EntropicEngineering/amm_connector/renders/connector_assembly.png

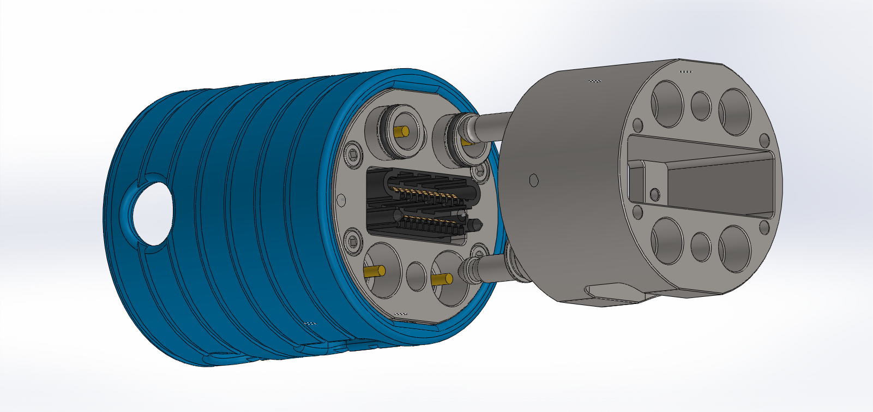
renders/connector_assembly.png
