EntropicEngineering/amm_connector/renders/schrader_test_block.png

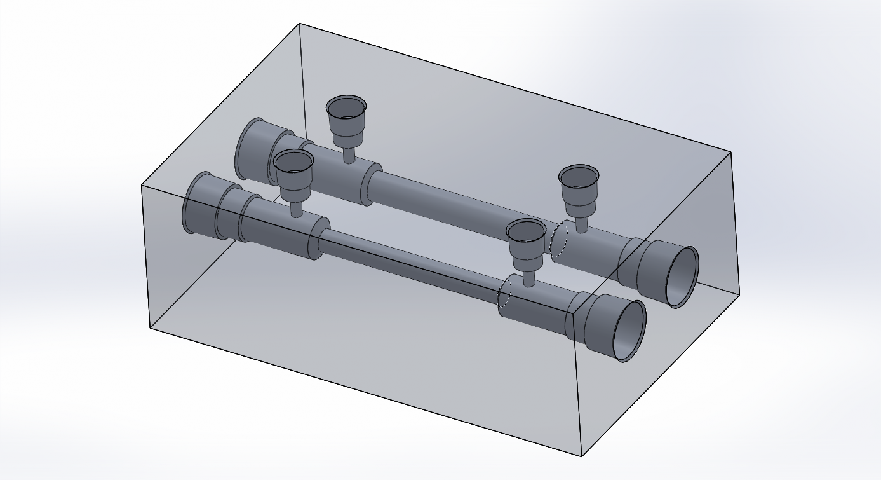
renders/schrader_test_block.png
