EntropicEngineering/amm_connector/README.md

This is a design of a standardized connector the the Advanced Modular Mankin (AMM) Project.
