EntropicEngineering/amm_connector/electrical_pinout.ods

Advanced Modular Manikin Connector Electrical Pinout
Connector Pin | Function | RJ-45 Ethernet Pin | Connector Pin | Function | RJ-45 Ethernet Pin | Mates
1 | +50V |  | 12 | +50V |  | Pin 1 mates with 12
2 | +50V |  | 13 | +50V |  | Pin 2 mates with 13
3 | +50V |  | 14 | +50V |  | Pin 3 mates with 14
4 | N/C |  | 15 | N/C |  | Pin 4 mates with 15
5 | GND |  | 16 | GND |  | Pin 5 mates with 16
6 | GND |  | 17 | GND |  | Pin 6 mates with 17
7 | GND |  | 18 | GND |  | Pin 7 mates with 18
8 | BI_DA+ | 1 | 19 | BI_DA- | 2 | Pin 8 mates with 19
9 | BI_DB+ | 3 | 20 | BI_DB- | 6 | Pin 9 mates with 20
10 | BI_DC+ | 4 | 21 | BI_DC- | 5 | Pin 10 mates with 21
11 | BI_DD+ | 7 | 22 | BI_DD- | 8 | Pin 11 mates with 22
Note
This electrical connector is designed to be fully non-gendered. The polarity of ethernet twisted pairs can be reversed during normal operation; the ethernet controller compensates for this.
