EntropicEngineering/amm_connector/body_model/skin_f_color.png

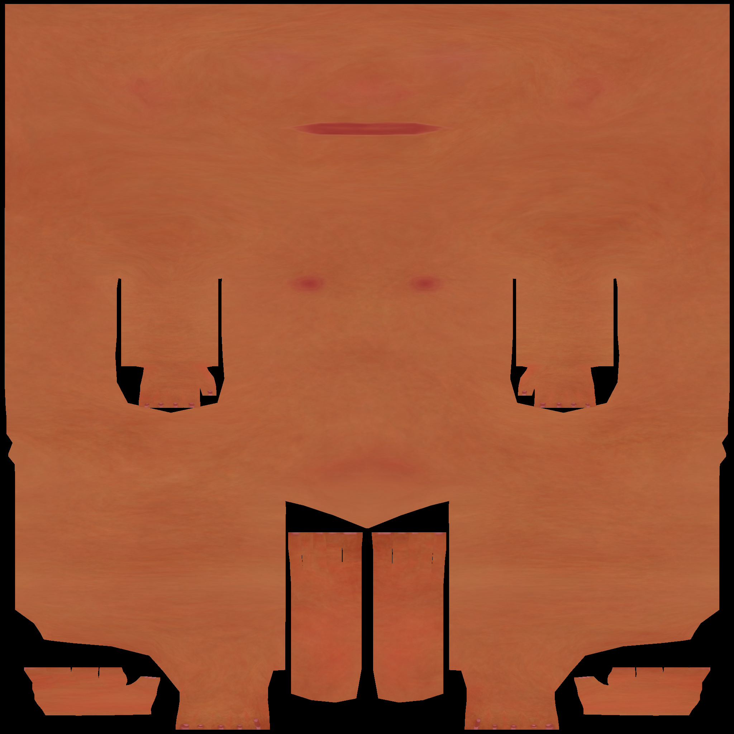
body_model/skin_f_color.png
