EntropicEngineering/amm_connector/body_model/skin_f_norm.png

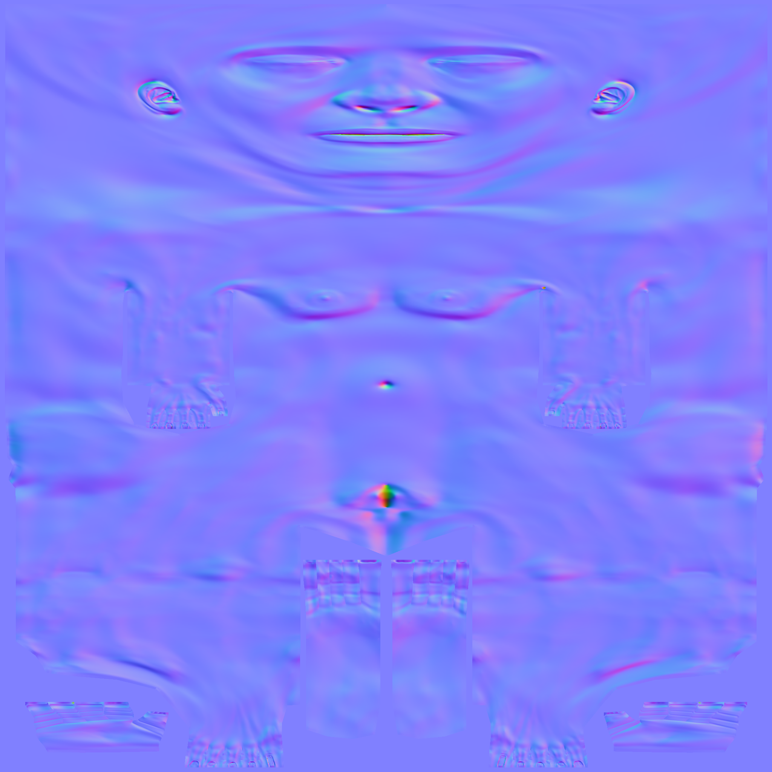
body_model/skin_f_norm.png
