EntropicEngineering/amm_connector/electrical_pinout.png

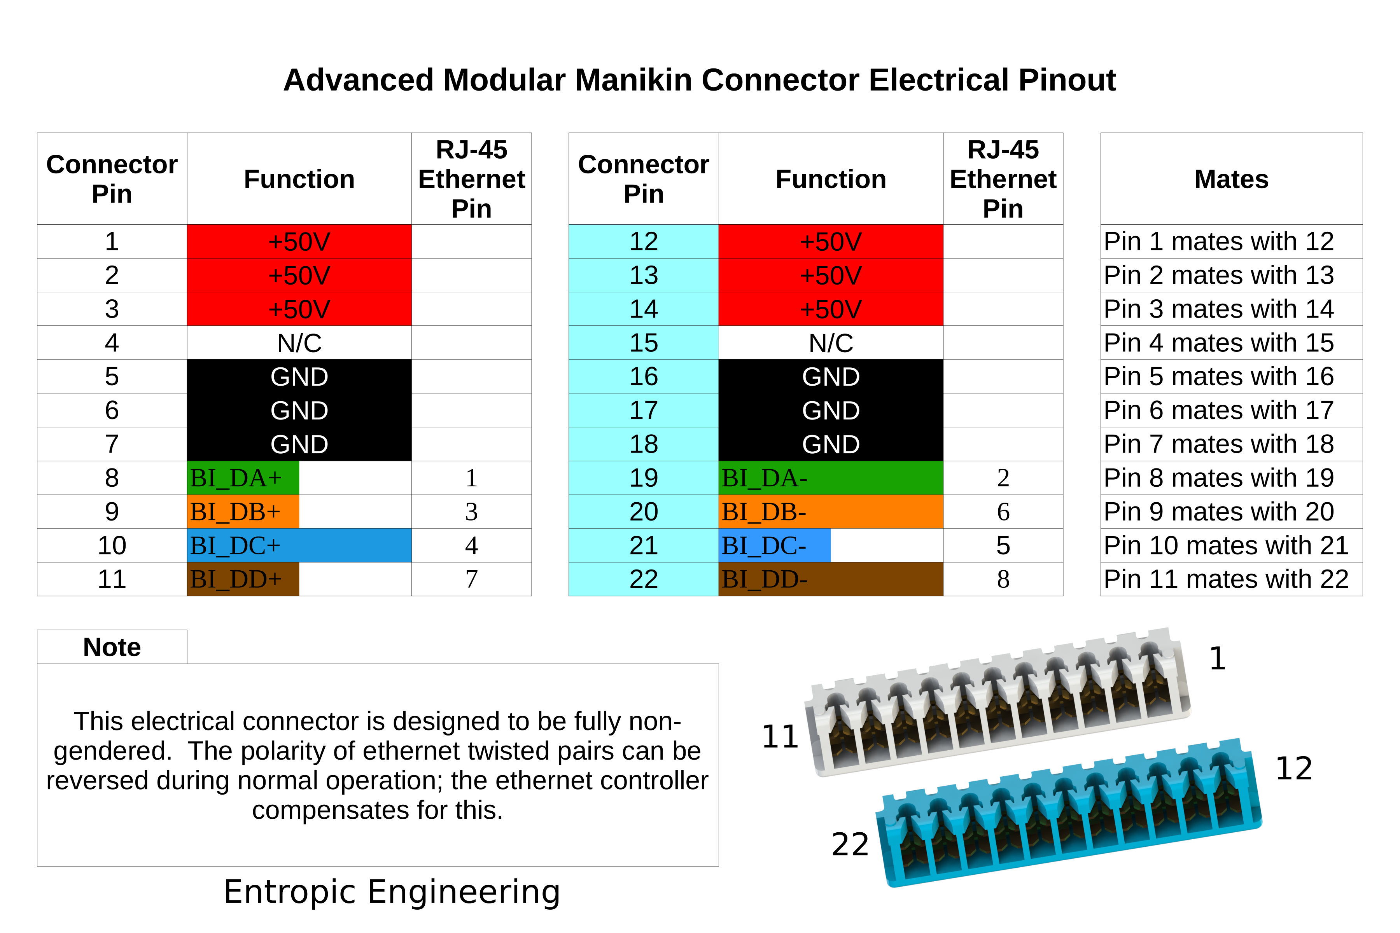
electrical_pinout.png
