EntropicEngineering/amm_connector/renders/connector2.png

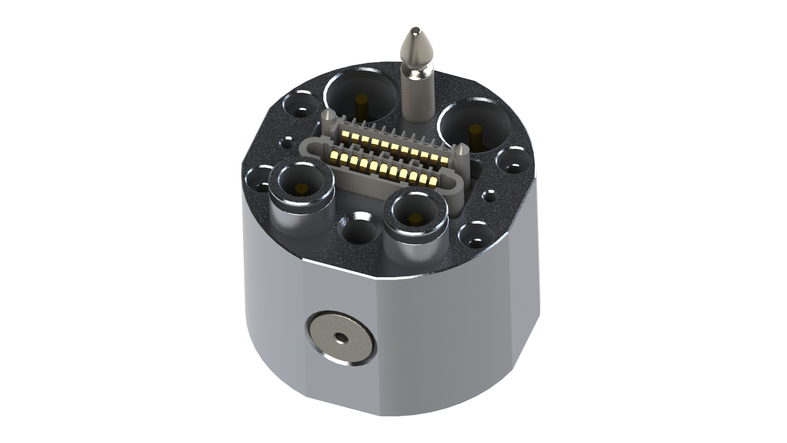
renders/connector2.png
