EntropicEngineering/amm_connector/renders/connector_draft.png

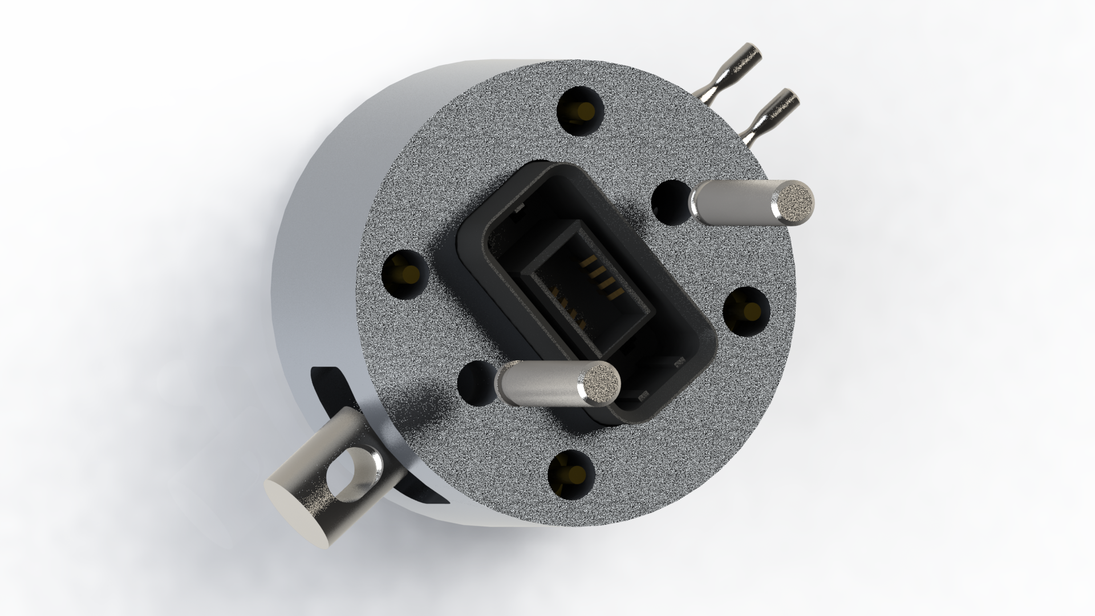
renders/connector_draft.png
