EntropicEngineering/amm_connector/renders/connector_draft_2.png

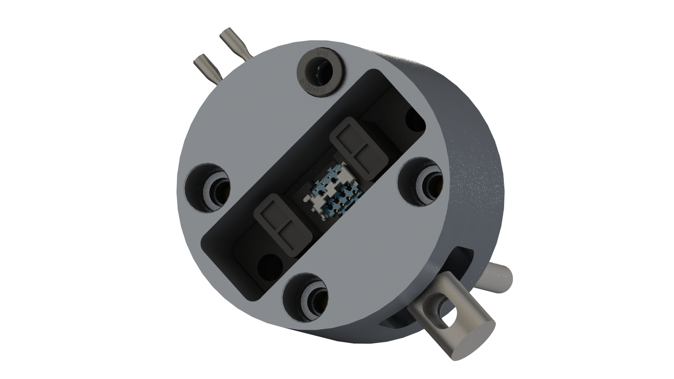
renders/connector_draft_2.png
