EntropicEngineering/amm_connector/renders/connector_draft_3.png

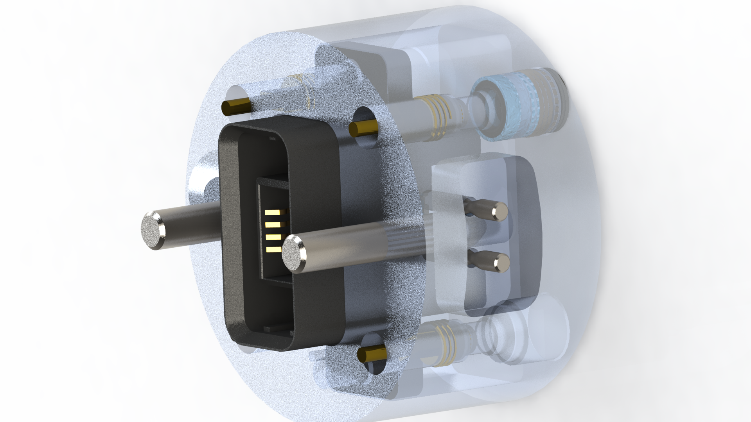
renders/connector_draft_3.png
