EntropicEngineering/amm_connector/renders/connector_draft_4.png

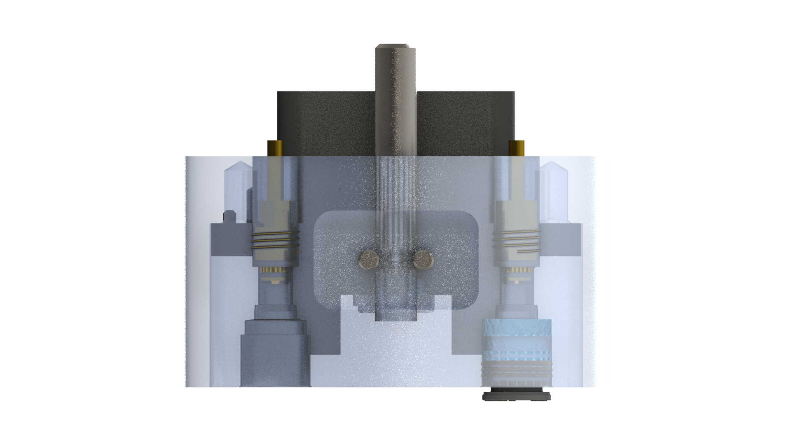
renders/connector_draft_4.png
