EntropicEngineering/amm_connector/renders/connector_draft_5.png

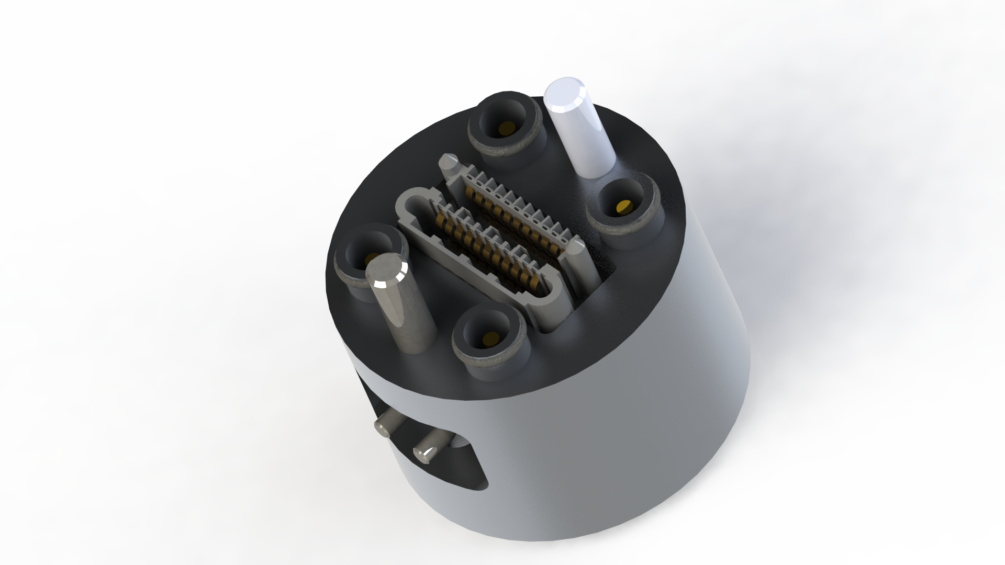
renders/connector_draft_5.png
