EntropicEngineering/amm_connector/renders/connector_draft_6.png

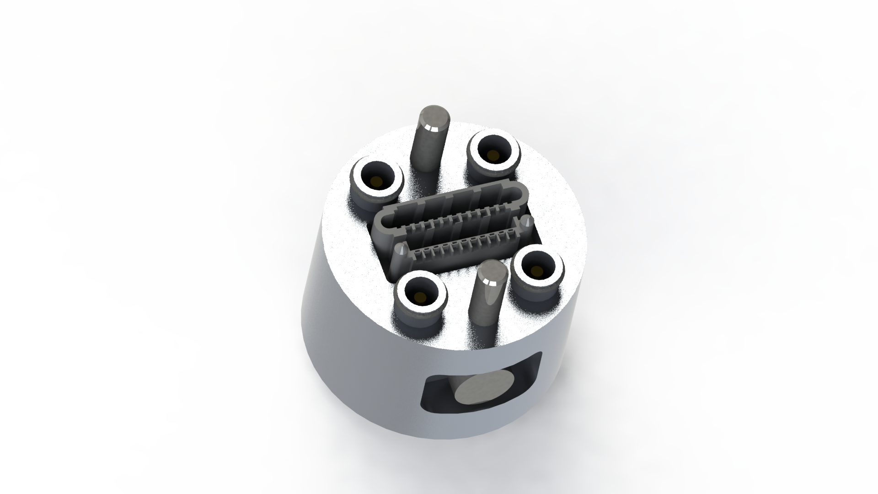
renders/connector_draft_6.png
