EntropicEngineering/amm_connector/renders/connector_draft_7.png

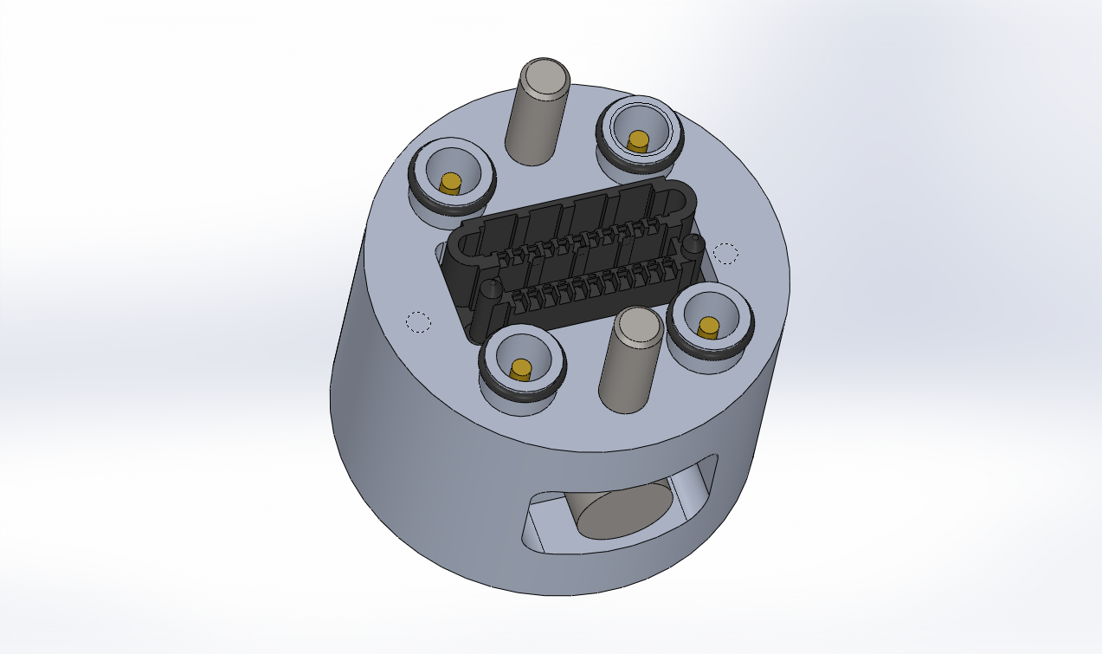
renders/connector_draft_7.png
