EntropicEngineering/amm_connector/renders/connector_draft_8.png

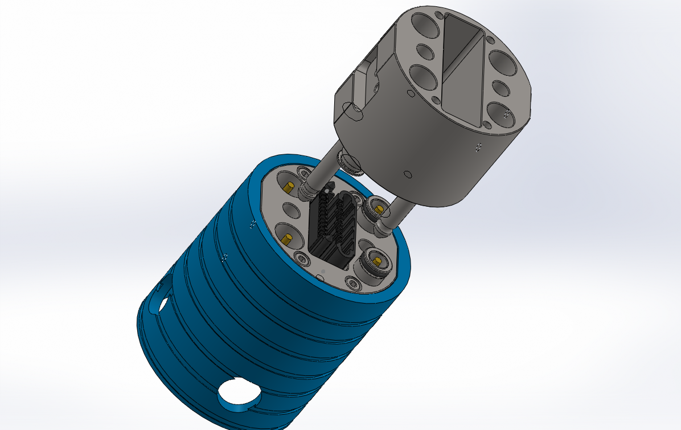
renders/connector_draft_8.png
