EntropicEngineering/amm_connector/renders/connector_draft_9.png

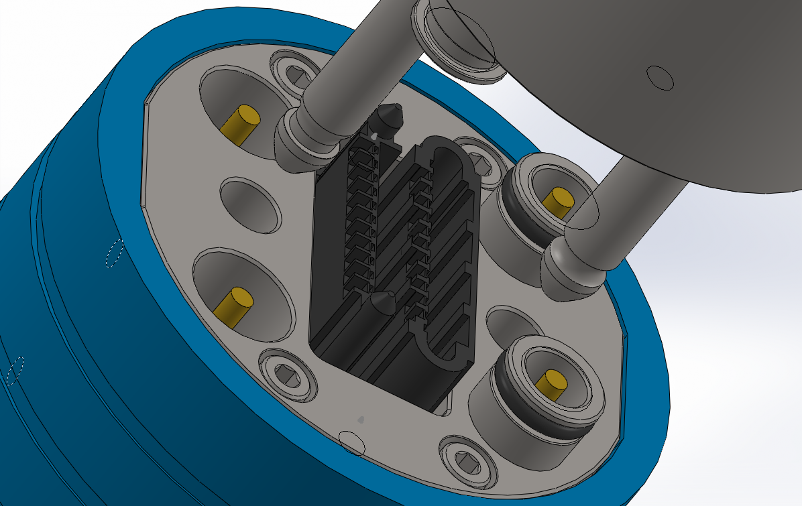
renders/connector_draft_9.png
