EntropicEngineering/amm_connector/renders/electrical_insert_blue.png

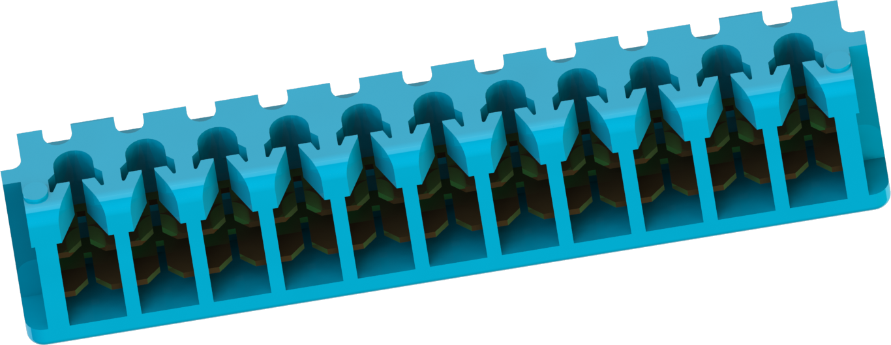
renders/electrical_insert_blue.png
