EntropicEngineering/amm_connector/fluid/hose_connector_subassembly.sldasm

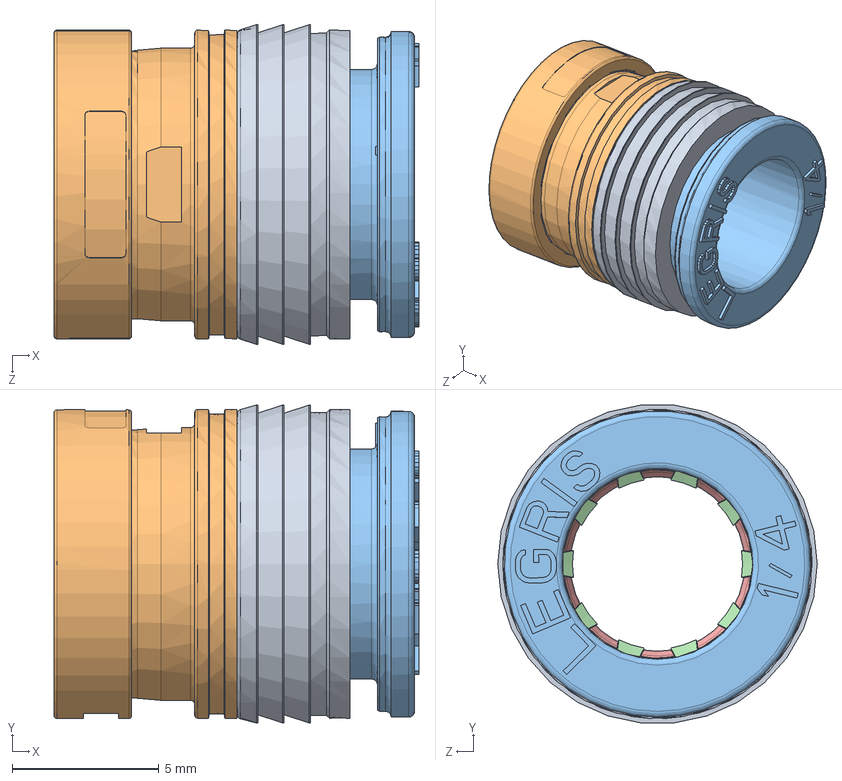
[picture p18: CAD file, 2018-06-09]
fluid/hose_connector_subassembly.sldasm
12.4 x 10.8 x 10.9 mm
