EntropicEngineering/amm_connector/electrical/electrical_subassembly.sldasm

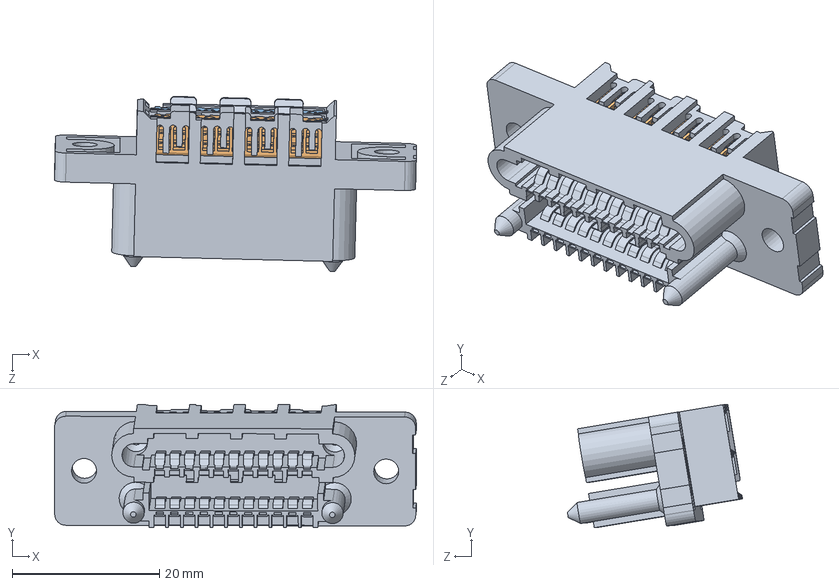
[picture p19: CAD file, 2018-11-02]
electrical/electrical_subassembly.sldasm
49.1 x 16.7 x 23.8 mm
