EntropicEngineering/amm_connector/electrical/electrical_assembly_a.sldasm

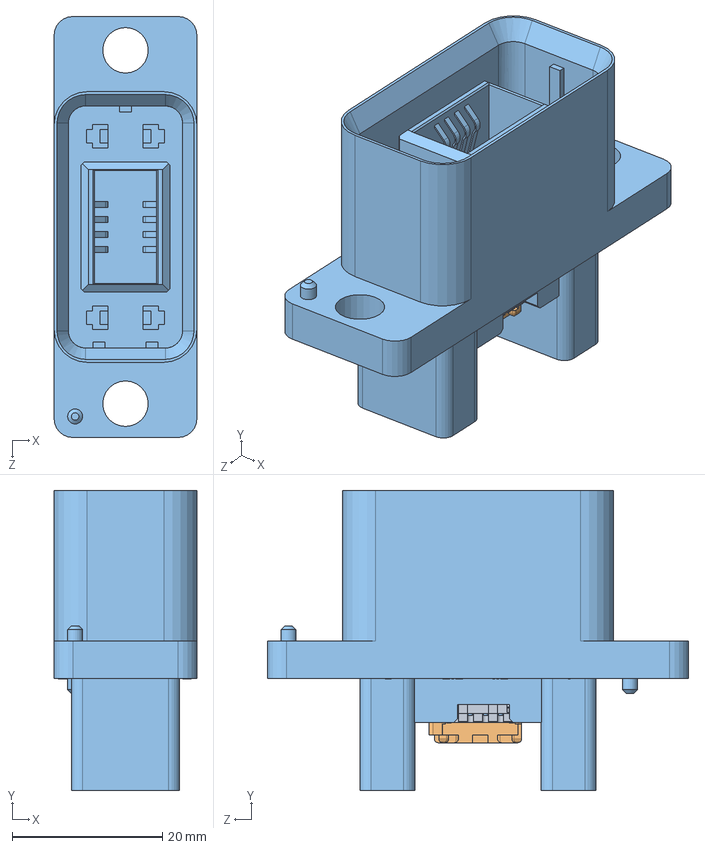
[picture p20: CAD file, 2018-06-05]
electrical/electrical_assembly_a.sldasm
19.0 x 39.9 x 56.0 mm
electrical_connector_a
idc_retainer
idc_insert x 2
