EntropicEngineering/amm_connector/jigs/release_button_jig.sldasm

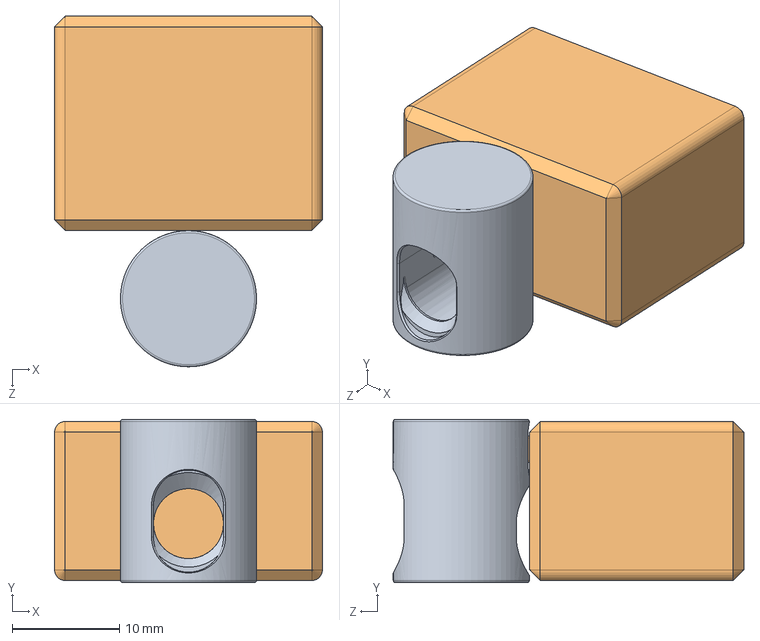
[picture p21: CAD file, 2018-08-15]
jigs/release_button_jig.sldasm
25.0 x 15.2 x 32.7 mm
