EntropicEngineering/amm_connector/body_model/skin_f_3.obj

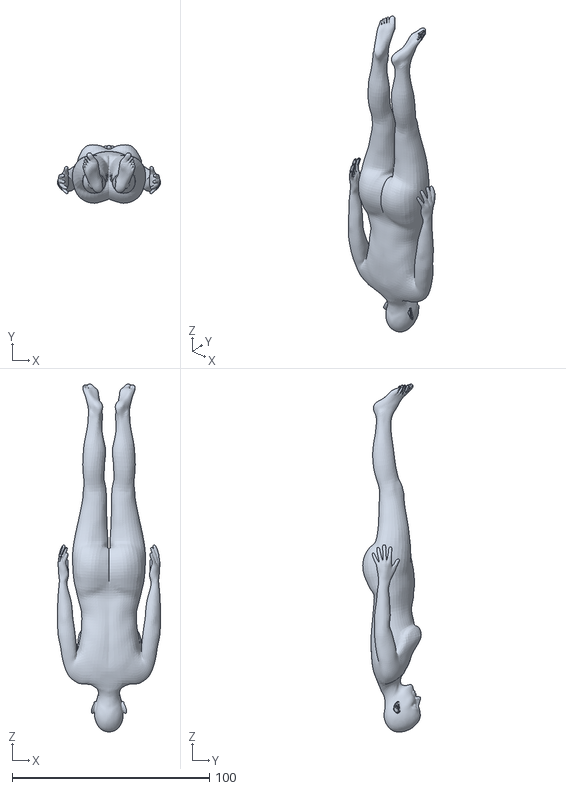
[picture p22: CAD file, 2022-07-11]
body_model/skin_f_3.obj
52.3 x 29.7 x 176.6
