EntropicEngineering/amm_connector/connector_interface_draft/connector_interface.stl

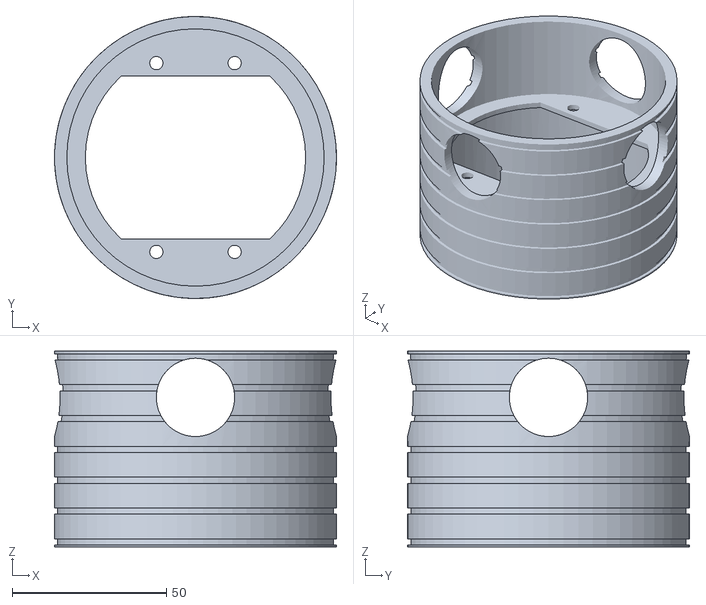
[picture p23: CAD file, 2018-05-30]
connector_interface_draft/connector_interface.stl
91.5 x 91.5 x 63.5
