EntropicEngineering/amm_connector/electrical/3-173977-1.stp

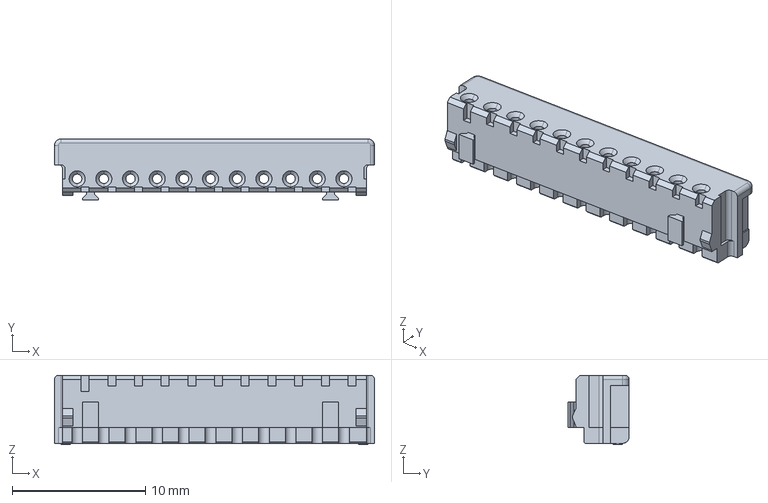
[picture p24: CAD file, 2022-07-11]
electrical/3-173977-1.stp
24.0 x 4.60 x 5.20 mm
