EntropicEngineering/amm_connector/fluid/m8_schrader_valve.sldprt

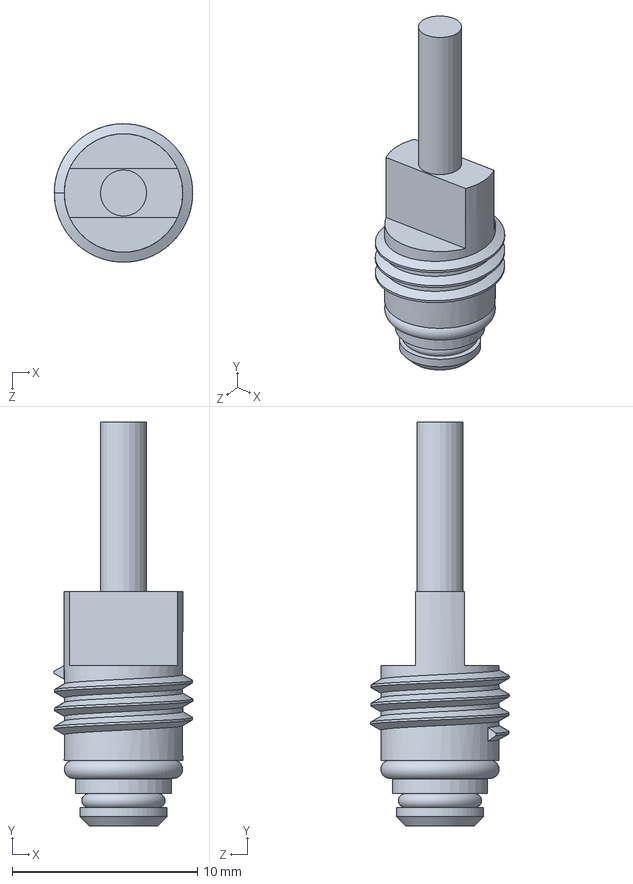
[picture p25: CAD file, 2018-09-17]
fluid/m8_schrader_valve.sldprt
7.48 x 21.8 x 7.48 mm
