EntropicEngineering/amm_connector/hardware/005_o-ring.sldprt

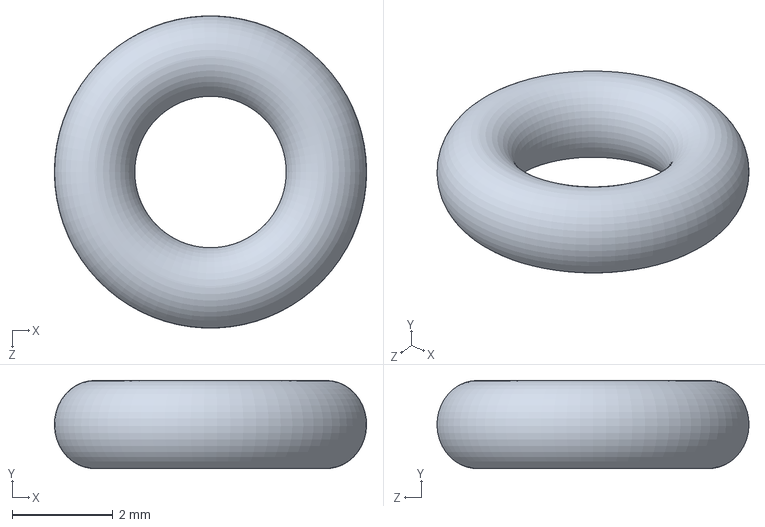
[picture p26: CAD file, 2018-11-02]
hardware/005_o-ring.sldprt
6.20 x 1.75 x 6.19 mm
