EntropicEngineering/amm_connector/schrader_valve_test_block/schrader_valve_test_block.sldprt

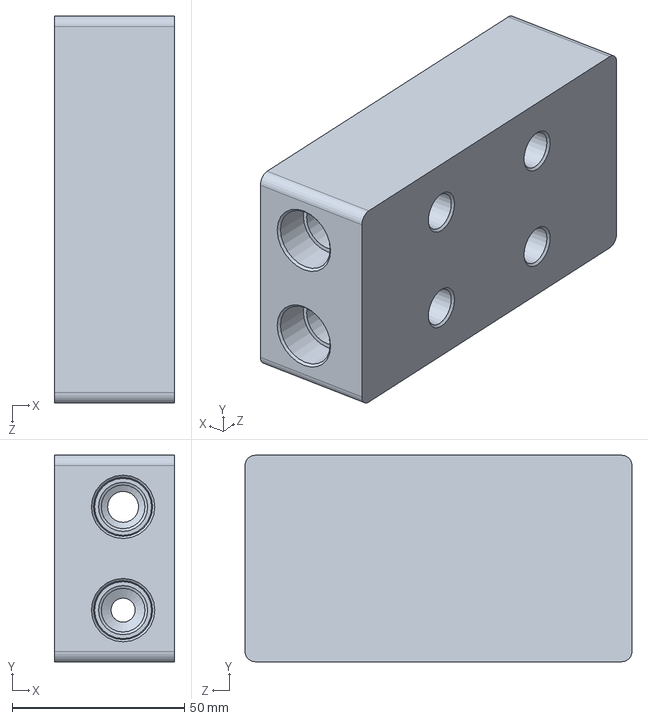
[picture p27: CAD file, 2018-08-29]
schrader_valve_test_block/schrader_valve_test_block.sldprt
35.0 x 60.0 x 112.4 mm
