EntropicEngineering/amm_connector/silicone_interface.sldprt

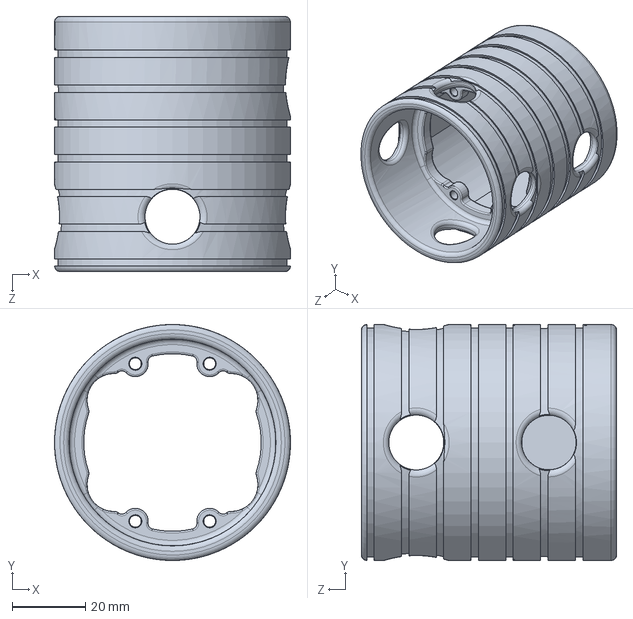
[picture p28: CAD file, 2022-07-11]
silicone_interface.sldprt
64.5 x 64.5 x 69.8 mm
