EntropicEngineering/amm_connector/connector_housing.step

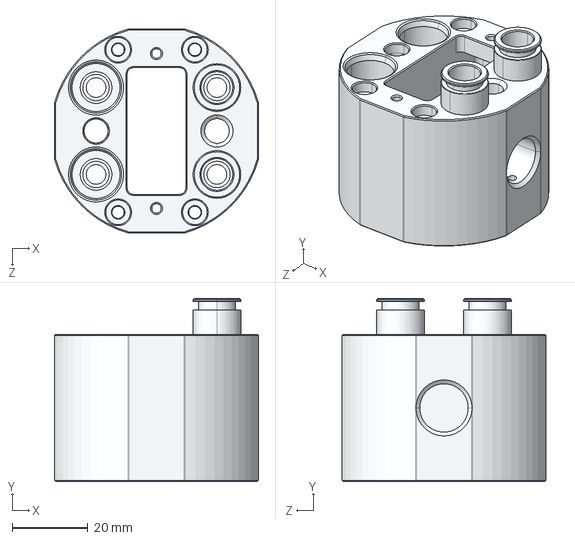
[picture p29: CAD file, 2022-07-11]
connector_housing.step
54.0 x 48.5 x 54.0 mm
