EntropicEngineering/amm_connector/fluid/m10_schrader_valve.sldprt

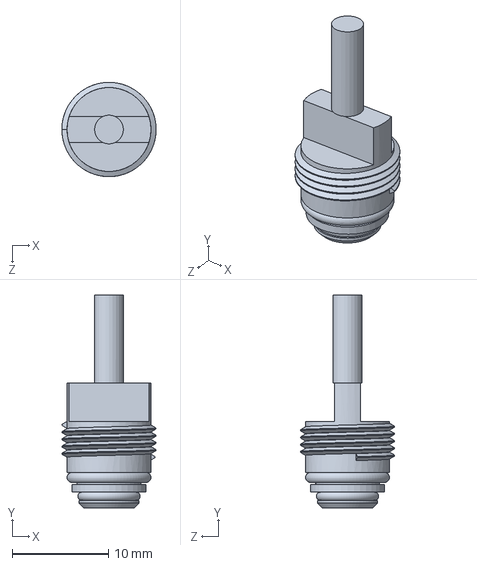
[picture p30: CAD file, 2018-09-11]
fluid/m10_schrader_valve.sldprt
9.81 x 22.1 x 9.81 mm
