EntropicEngineering/amm_connector/hardware/012_o-ring.sldprt

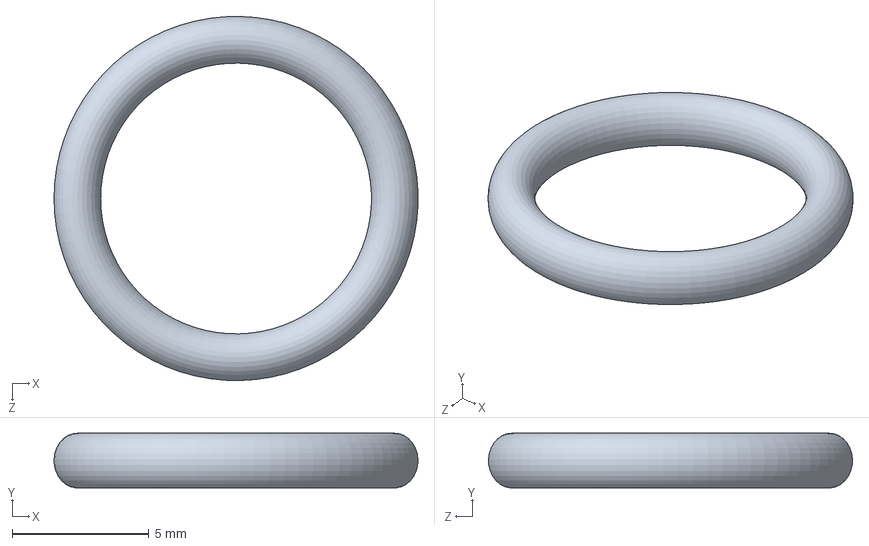
[picture p31: CAD file, 2018-11-02]
hardware/012_o-ring.sldprt
13.3 x 2.00 x 13.3 mm
