EntropicEngineering/amm_connector/jigs/connector_housing_soft_jaws.sldprt

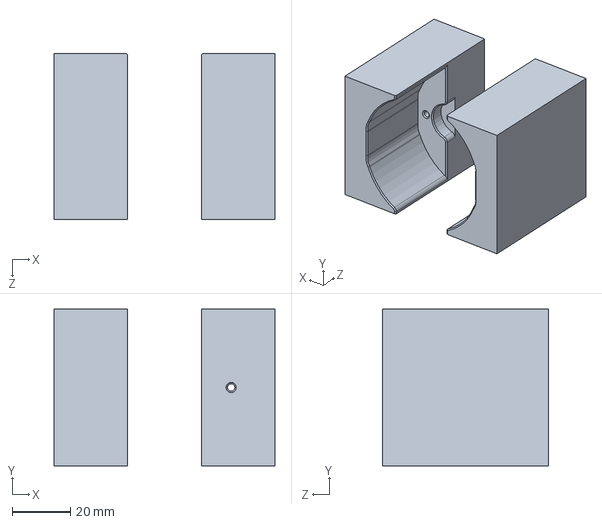
[picture p32: CAD file, 2022-07-11]
jigs/connector_housing_soft_jaws.sldprt
76.2 x 54.0 x 57.1 mm
