EntropicEngineering/amm_connector/jigs/bend_test_jig.sldprt

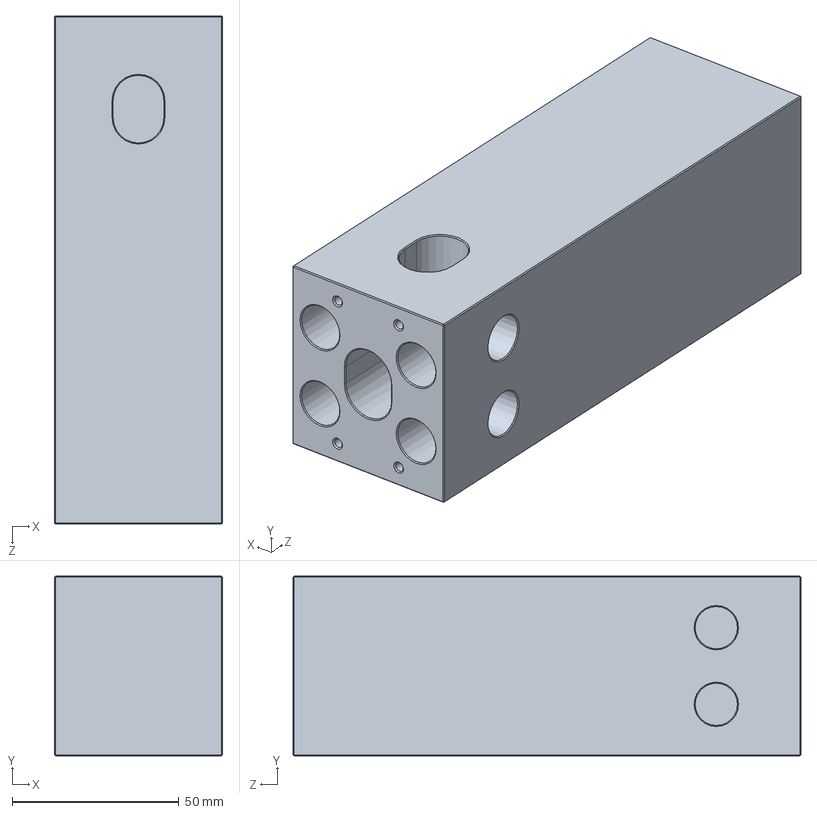
[picture p33: CAD file, 2019-12-22]
jigs/bend_test_jig.sldprt
50.4 x 53.9 x 152.4 mm
