EntropicEngineering/amm_connector/release_button.sldprt

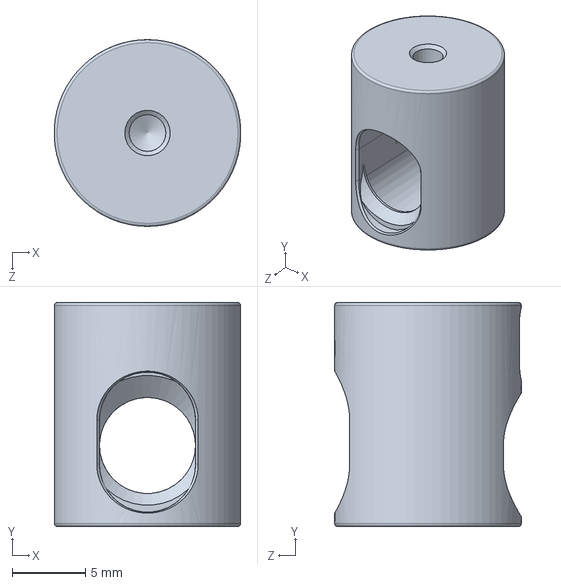
[picture p34: CAD file, 2018-12-05]
release_button.sldprt
12.7 x 15.2 x 12.7 mm
