EntropicEngineering/amm_connector/fluid/3100_56_00_99_05.sldprt

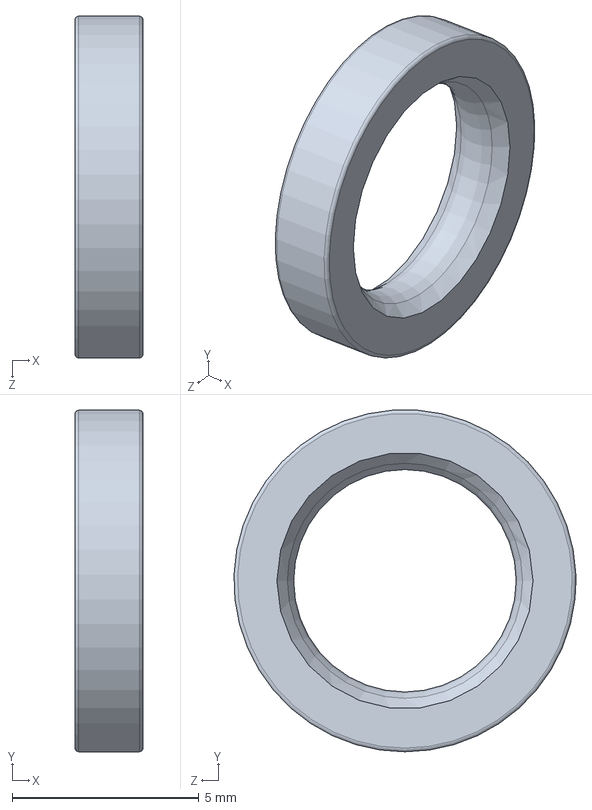
[picture p35: CAD file, 2018-05-30]
fluid/3100_56_00_99_05.sldprt
1.82 x 9.14 x 9.15 mm
