EntropicEngineering/amm_connector/jigs/connector_pocket_jig.sldprt

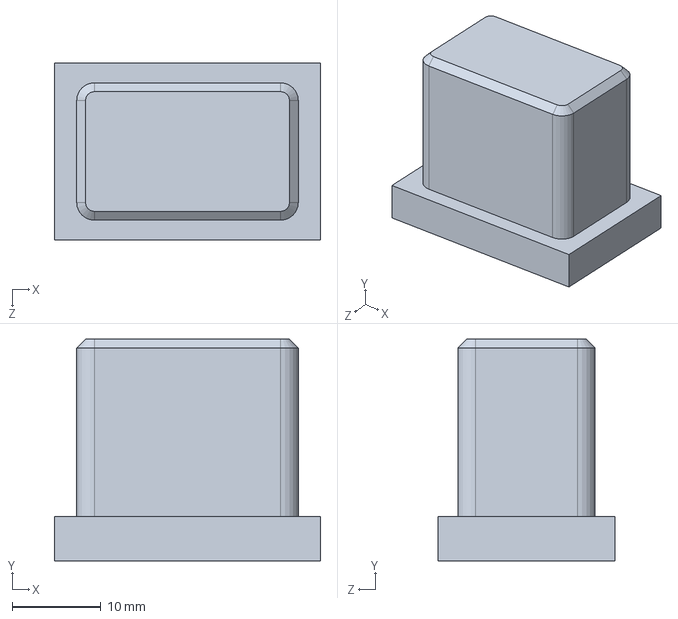
[picture p36: CAD file, 2019-01-03]
jigs/connector_pocket_jig.sldprt
30.0 x 25.0 x 20.0 mm
