EntropicEngineering/amm_connector/latch_pin.sldprt

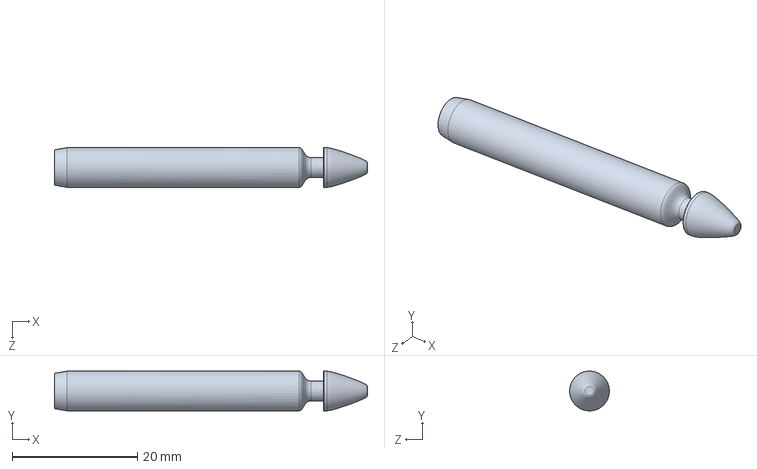
[picture p37: CAD file, 2018-12-05]
latch_pin.sldprt
50.0 x 6.35 x 6.35 mm
