EntropicEngineering/amm_connector/fluid/3100_56_00_99_02.sldprt

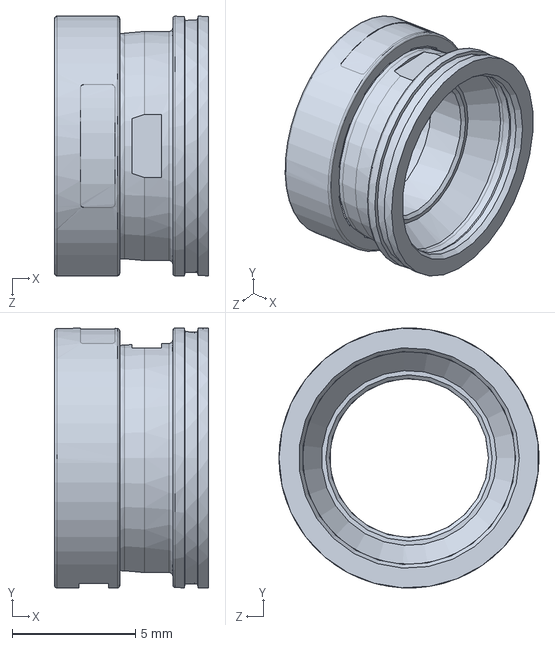
[picture p38: CAD file, 2018-05-30]
fluid/3100_56_00_99_02.sldprt
6.25 x 10.5 x 10.6 mm
