EntropicEngineering/amm_connector/connector_housing_m10.sldprt

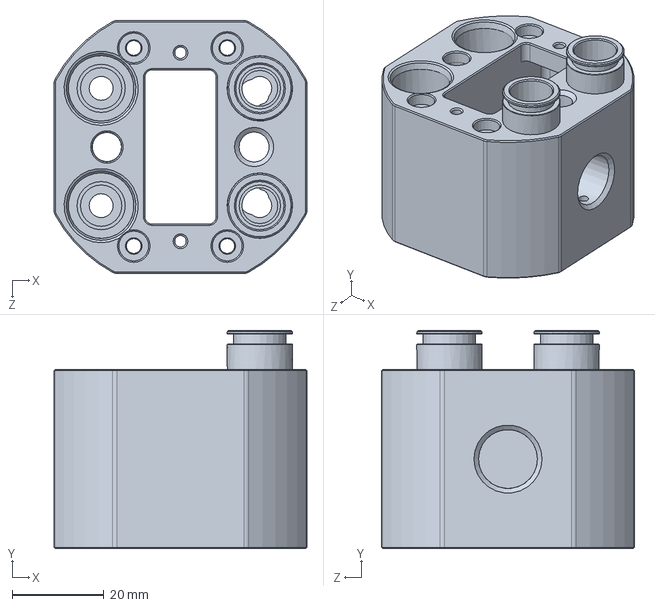
[picture p39: CAD file, 2018-08-29]
connector_housing_m10.sldprt
55.0 x 47.5 x 55.0 mm
