EntropicEngineering/amm_connector/electrical/idc_insert.sldprt

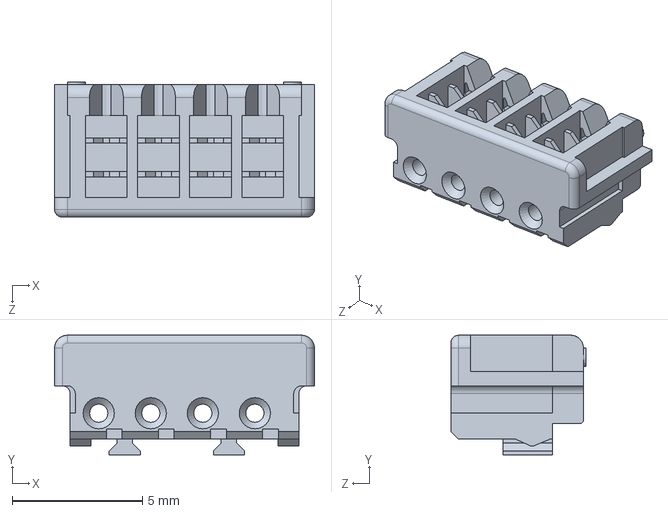
[picture p40: CAD file, 2018-06-04]
electrical/idc_insert.sldprt
9.99 x 4.60 x 5.20 mm
