EntropicEngineering/amm_connector/fluid/3100_56_00_99_04.sldprt

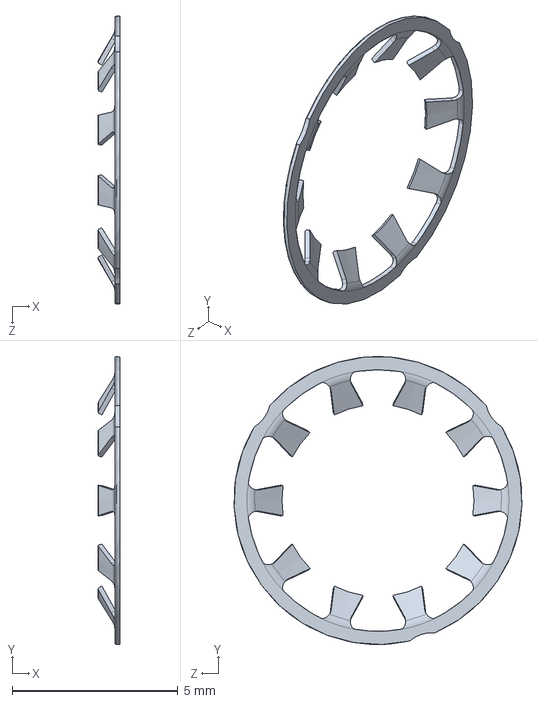
[picture p41: CAD file, 2018-05-30]
fluid/3100_56_00_99_04.sldprt
0.651 x 8.70 x 8.69 mm
