EntropicEngineering/amm_connector/jigs/hose_press_jig.sldprt

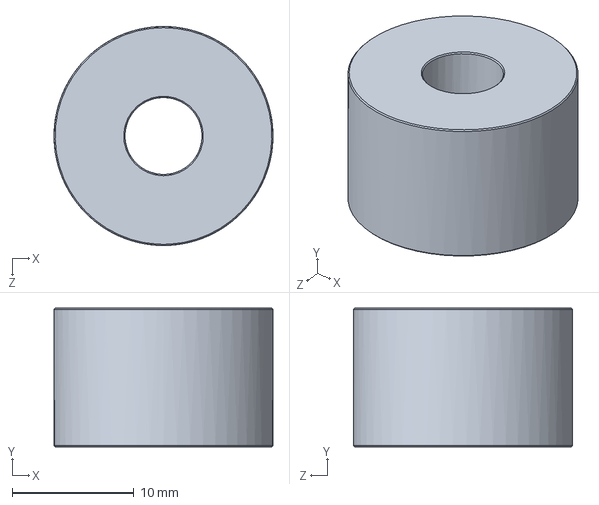
[picture p42: CAD file, 2018-08-08]
jigs/hose_press_jig.sldprt
18.0 x 11.4 x 18.0 mm
