EntropicEngineering/amm_connector/electrical/idc_retainer.sldprt

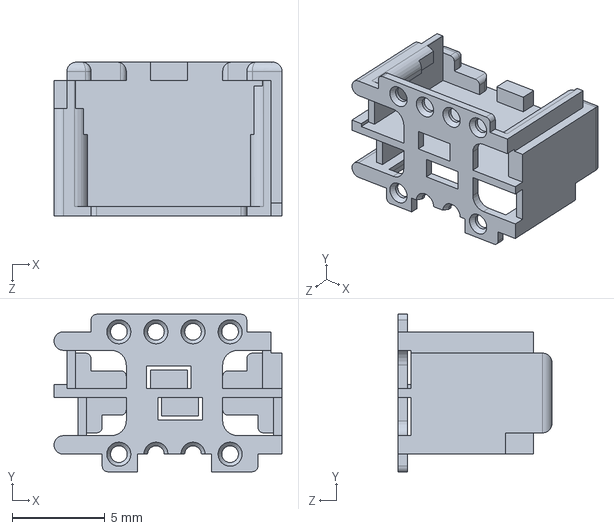
[picture p43: CAD file, 2018-06-04]
electrical/idc_retainer.sldprt
12.3 x 8.50 x 8.30 mm
