EntropicEngineering/amm_connector/fluid/3100_56_00_99_01.sldprt

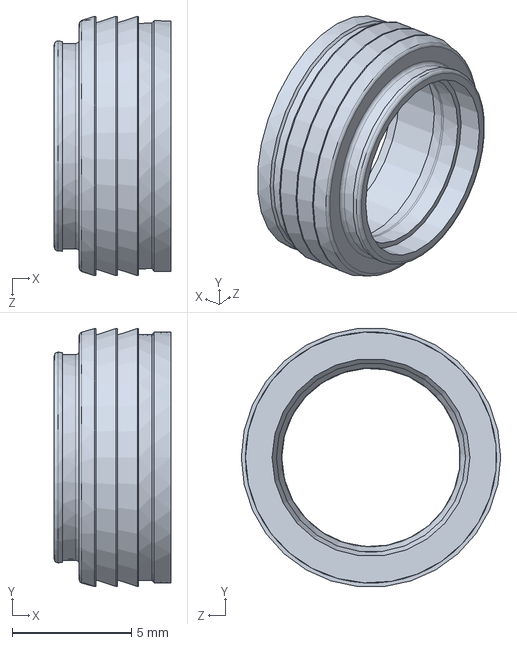
[picture p44: CAD file, 2018-05-30]
fluid/3100_56_00_99_01.sldprt
4.90 x 10.8 x 10.9 mm
