EntropicEngineering/amm_connector/hardware/010_o-ring.sldprt

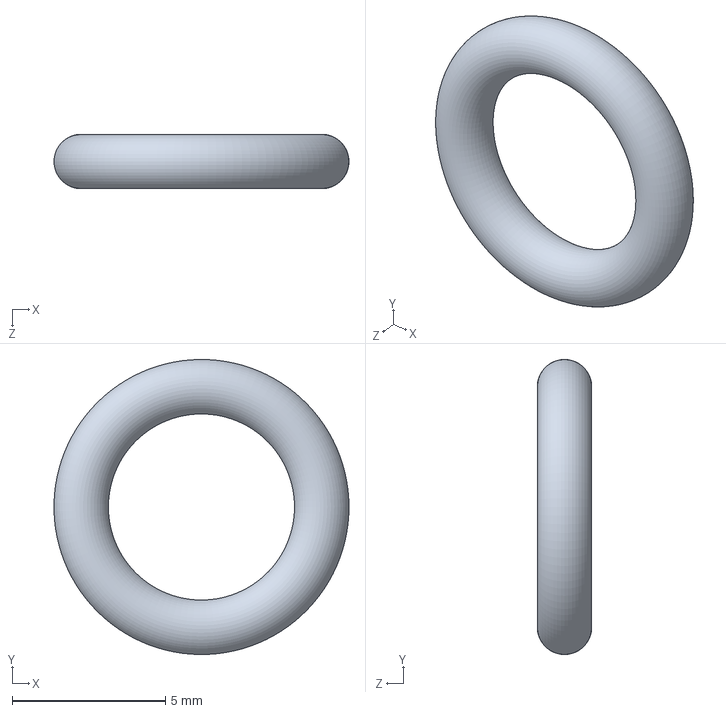
[picture p45: CAD file, 2018-07-16]
hardware/010_o-ring.sldprt
9.62 x 9.63 x 1.77 mm
