EntropicEngineering/amm_connector/jigs/latch_pin_press_jig.sldprt

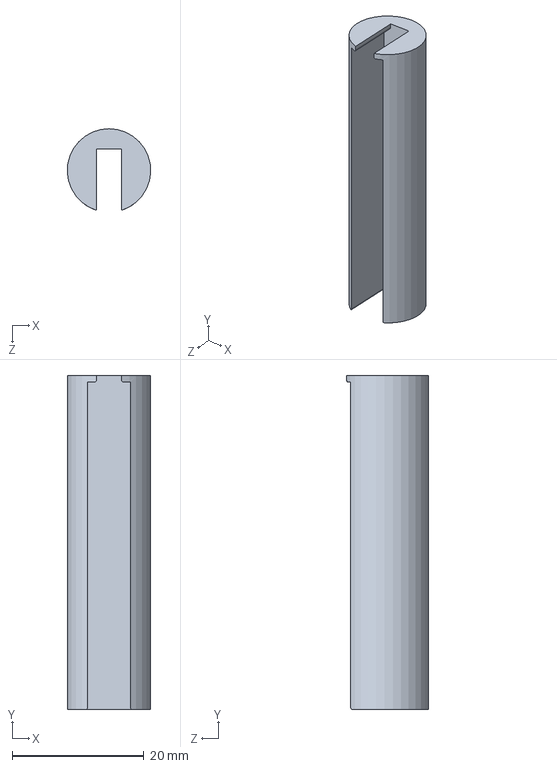
[picture p46: CAD file, 2018-08-08]
jigs/latch_pin_press_jig.sldprt
12.7 x 50.8 x 12.4 mm
