EntropicEngineering/amm_connector/silicone_sleeve.sldprt

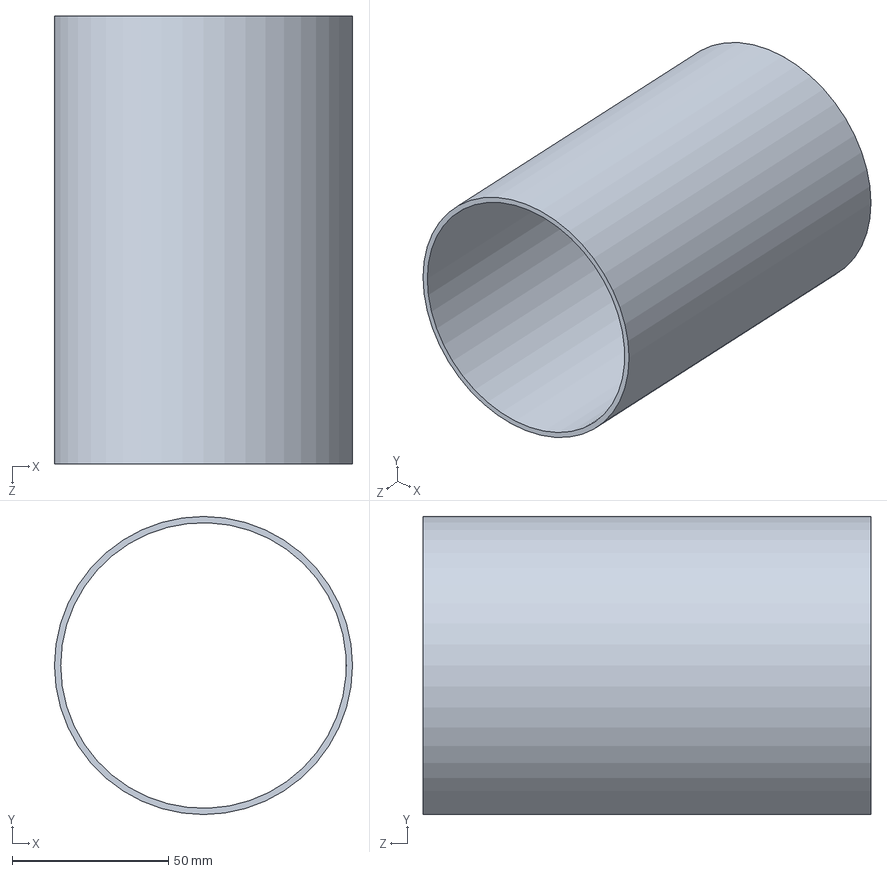
[picture p47: CAD file, 2018-07-10]
silicone_sleeve.sldprt
95.5 x 95.5 x 143.5 mm
