EntropicEngineering/amm_connector/fluid/3100_56_00_99_03.sldprt

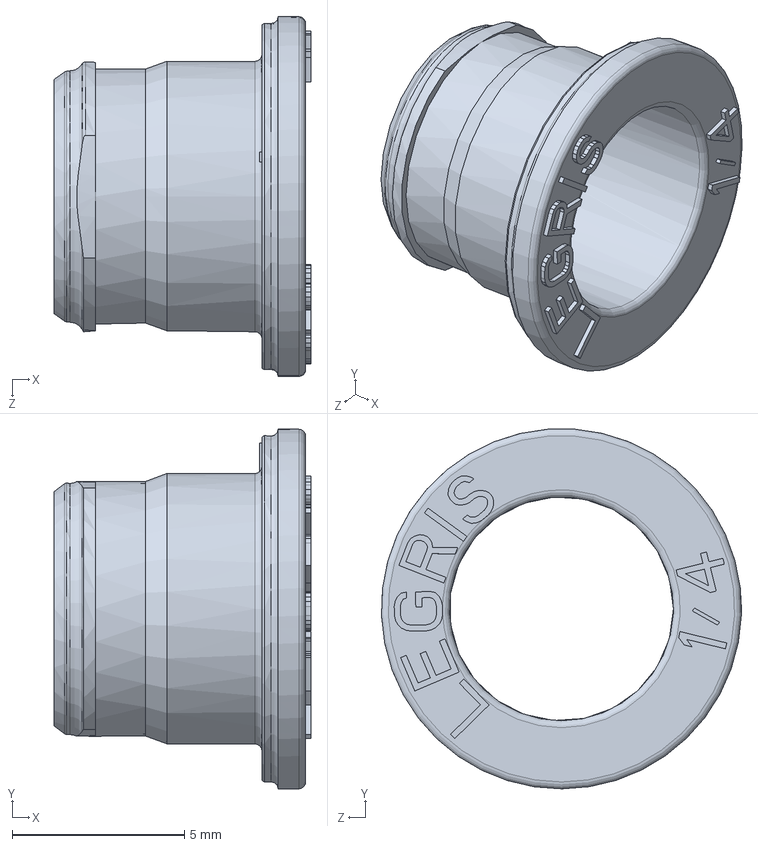
[picture p48: CAD file, 2018-05-30]
fluid/3100_56_00_99_03.sldprt
7.45 x 10.4 x 10.4 mm
