EntropicEngineering/amm_connector/hardware/conical_spring.sldprt

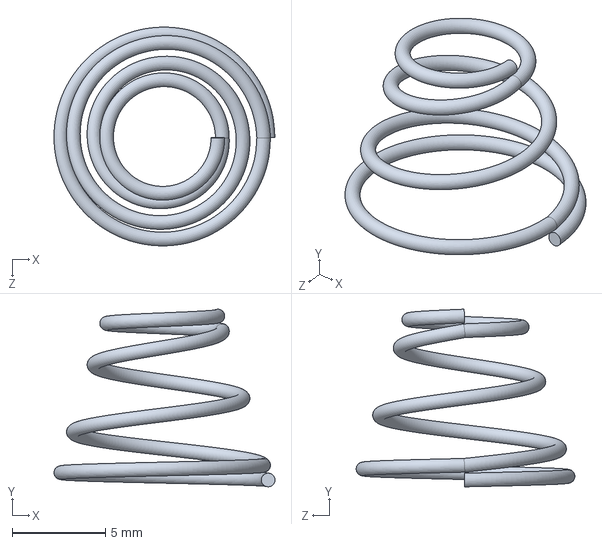
[picture p49: CAD file, 2018-07-07]
hardware/conical_spring.sldprt
11.8 x 9.53 x 11.7 mm
