EntropicEngineering/amm_connector/electrical/electrical_connector_a.sldprt

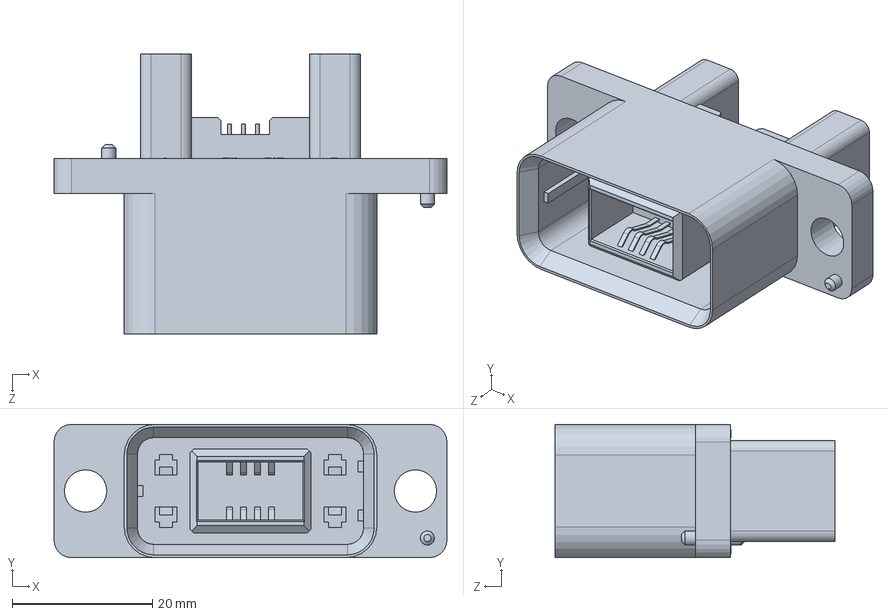
[picture p50: CAD file, 2018-06-02]
electrical/electrical_connector_a.sldprt
56.0 x 19.0 x 39.9 mm
