EntropicEngineering/amm_connector/hardware/m3_threaded_insert.sldprt

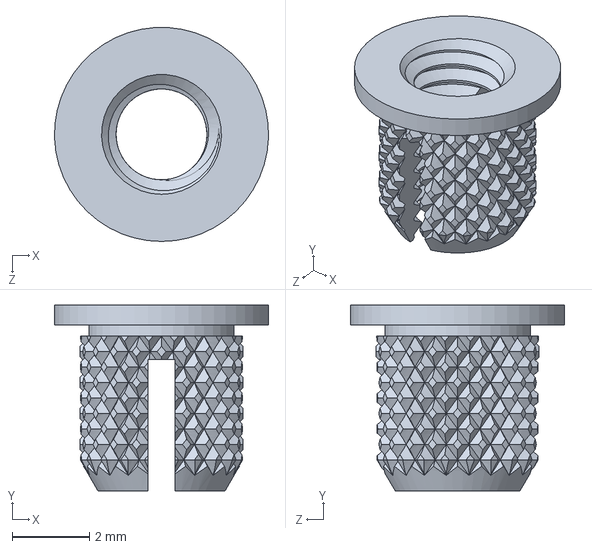
[picture p51: CAD file, 2018-06-15]
hardware/m3_threaded_insert.sldprt
5.53 x 4.80 x 5.53 mm
