EntropicEngineering/amm_connector/electrical/electrical_connector_b.sldprt

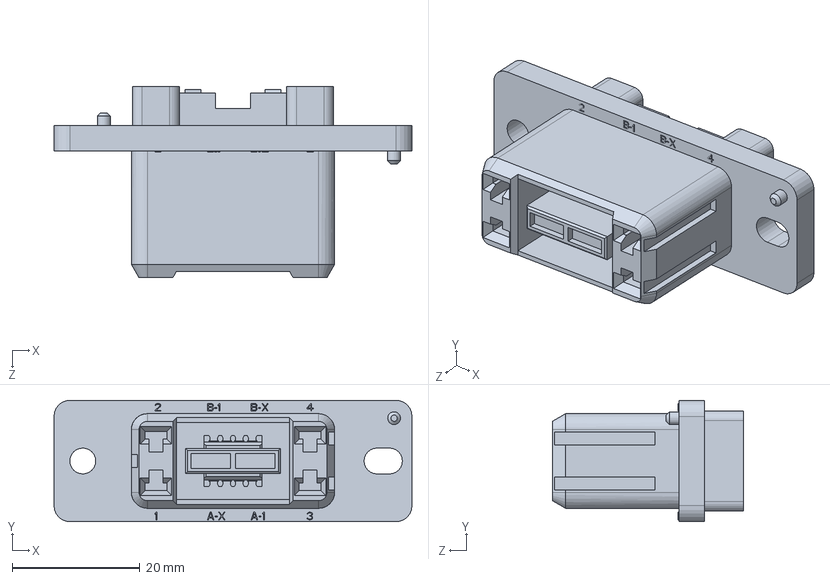
[picture p52: CAD file, 2018-06-02]
electrical/electrical_connector_b.sldprt
56.0 x 19.0 x 30.0 mm
