EntropicEngineering/amm_connector/(list of files, cad)

Other CAD files:
electrical/1-173977-1.sldprt
connector_housing.slddrw
connector_housing.sldprt
connector_housing_cam.f3d
electrical/173977-4.stp
electrical/179472-8.stp
electrical/292178-1.sldprt
electrical/292178-1.stp
electrical/292182-8.stp
electrical/292185-8.stp
electrical/3-173977-1.sldprt
hardware/m3_rubber_washer.sldprt
hardware/m3_steel_washer.sldprt
hardware/m3x10mm_screw.sldprt
hardware/m3x40mm_screw.sldprt
hardware/m3x8mm_set_screw.sldprt
jigs/bend_test_jig.slddrw
jigs/latch_pin_spacer.slddrw
jigs/release_button_jig.sldprt
latch_pin.slddrw
release_button.slddrw
release_button_cam.f3d
