EntropicEngineering/amm_connector/schrader_valve_test_block/test_block_notes.txt

Notes for schrader valve test block

M8 threaded length:
32mm

M10 threaded length:
34mm
