EntropicEngineering/amm_connector/jigs/bend_test_jig.png

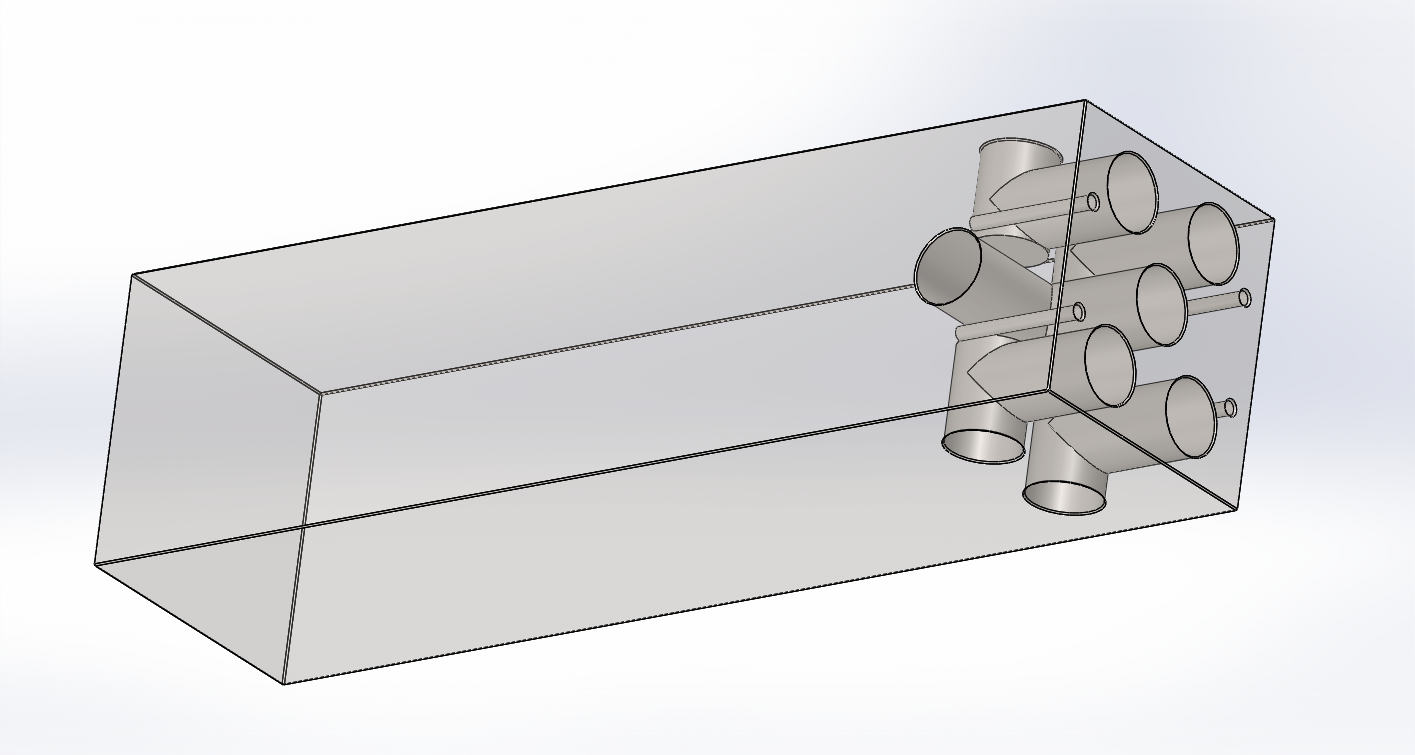
jigs/bend_test_jig.png
