EntropicEngineering/amm_connector/jigs/bend_test_jig.pdf

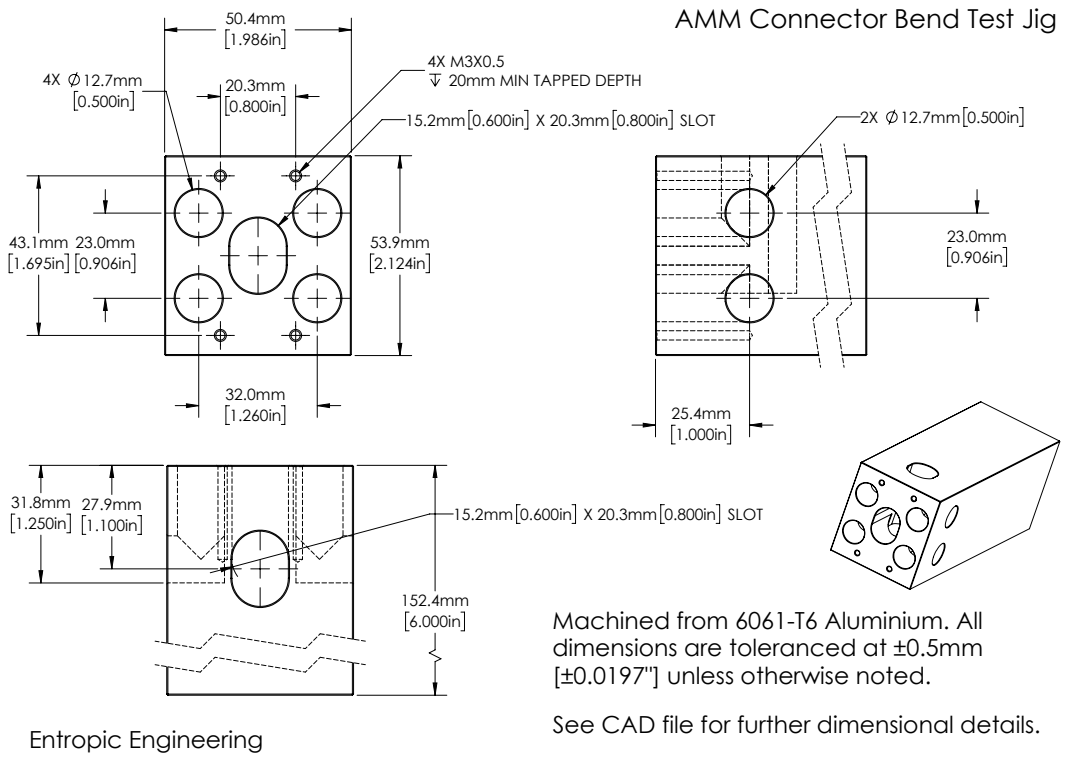
[picture p54: page 1]
20mm MIN TAPPED DEPTH; 15.2mm 0.600in X 20.3mm 0.800in SLOT; 15.2mm 0.600in X 20.3mm 0.800in SLOT 27.9mm

AMM Connector Bend Test Jig

Machined from 6061-T6 Aluminium. All
dimensions are toleranced at ±0.5mm
[±0.0197"] unless otherwise noted.

See CAD file for further dimensional details. Entropic Engineering
