EntropicEngineering/amm_connector/documentation/electrical_pinout.pdf

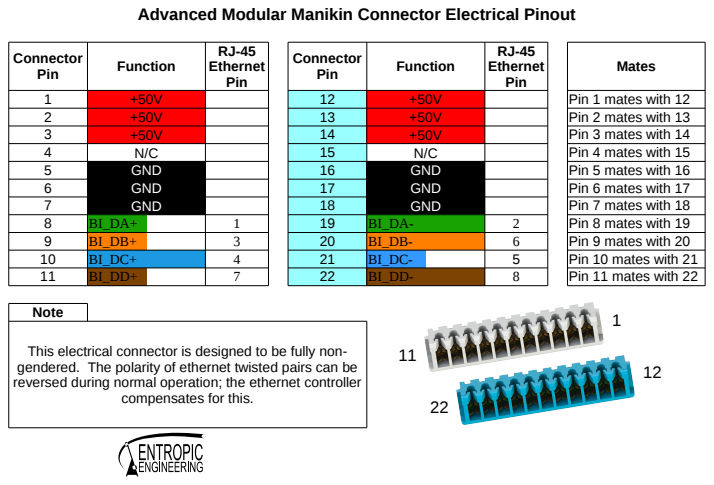
[picture p55: page 1]
Function; Mates; Pin 1 mates with 12; Pin 2 mates with 13; Pin 3 mates with 14; Pin 4 mates with 15; GND; Pin 5 mates with 16; Pin 6 mates with 17; Pin 7 mates with 18; Pin 8 mates with 19; Pin 9 mates with 20; Pin 10 mates with 21; Pin 11 mates with 22; Note; Connector Pin; RJ-45 Ethernet Pin

Advanced Modular Manikin Connector Electrical Pinout

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

compensates for this.
