EntropicEngineering/amm_connector/documentation/connector_housing.pdf

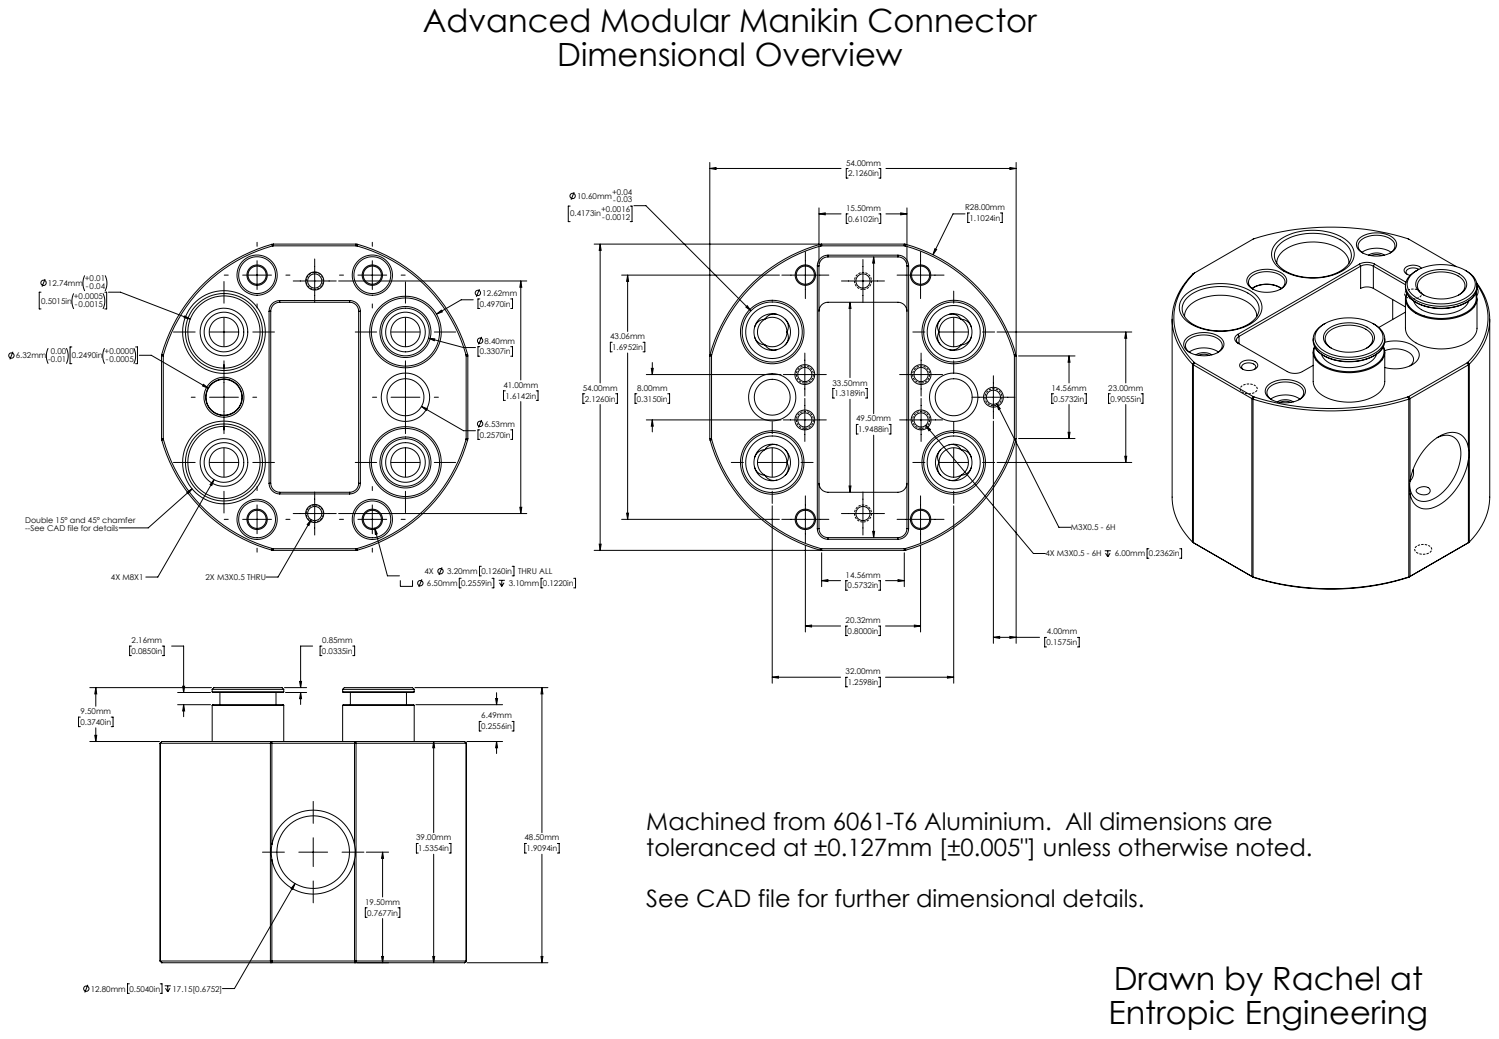
[picture p56: page 1]
2X M3X0.5 THRU; 3.20mm 0.1260in THRU ALL; Dimensional Overview

Advanced Modular Manikin Connector

Double 15° and 45° chamfer
--See CAD file for details

Machined from 6061-T6 Aluminium. All dimensions are
toleranced at ±0.127mm [±0.005"] unless otherwise noted.
See CAD file for further dimensional details.

Drawn by Rachel at
Entropic Engineering
