EntropicEngineering/amm_connector/documentation/connector.pdf

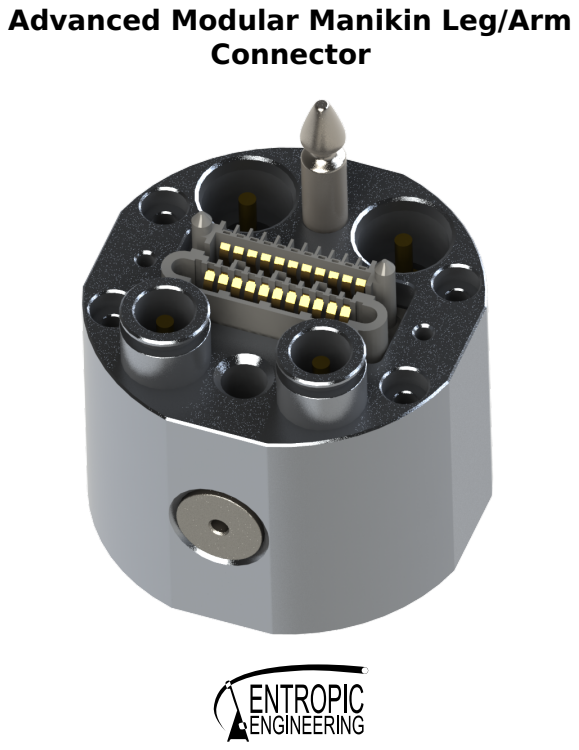
[picture p57: page 1]
Connector

Advanced Modular Manikin Leg/Arm
