EntropicEngineering/amm_connector/documentation/connector_exploded_view.pdf

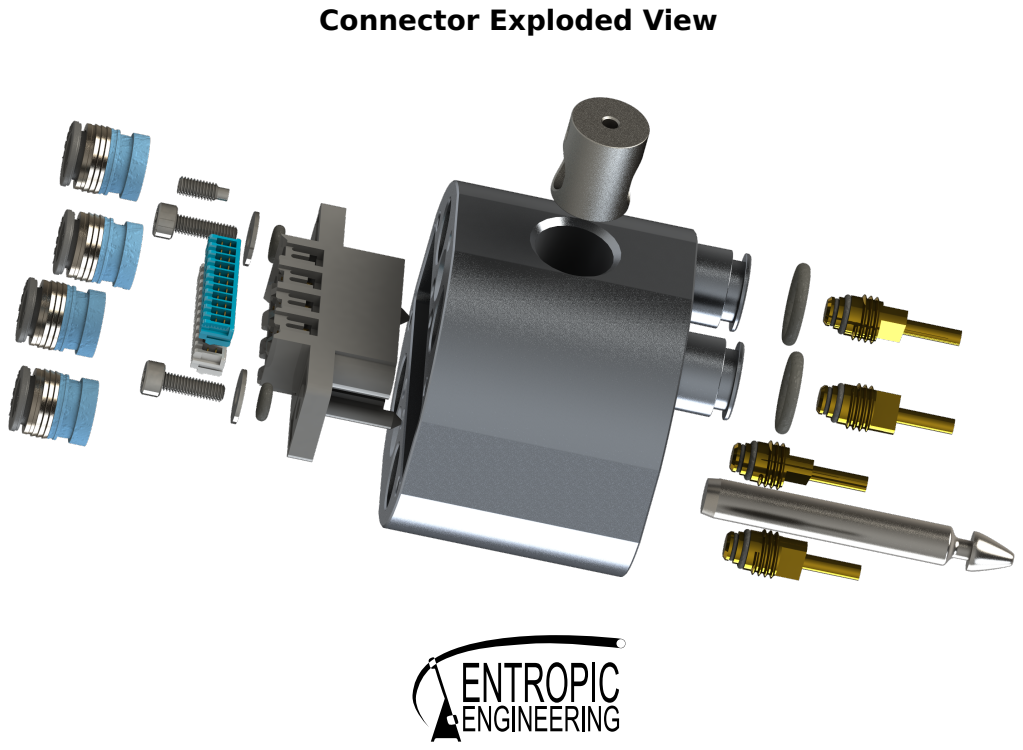
[picture p58: page 1]

Connector Exploded View
