EntropicEngineering/amm_connector/documentation/connector_interface_exploded.pdf

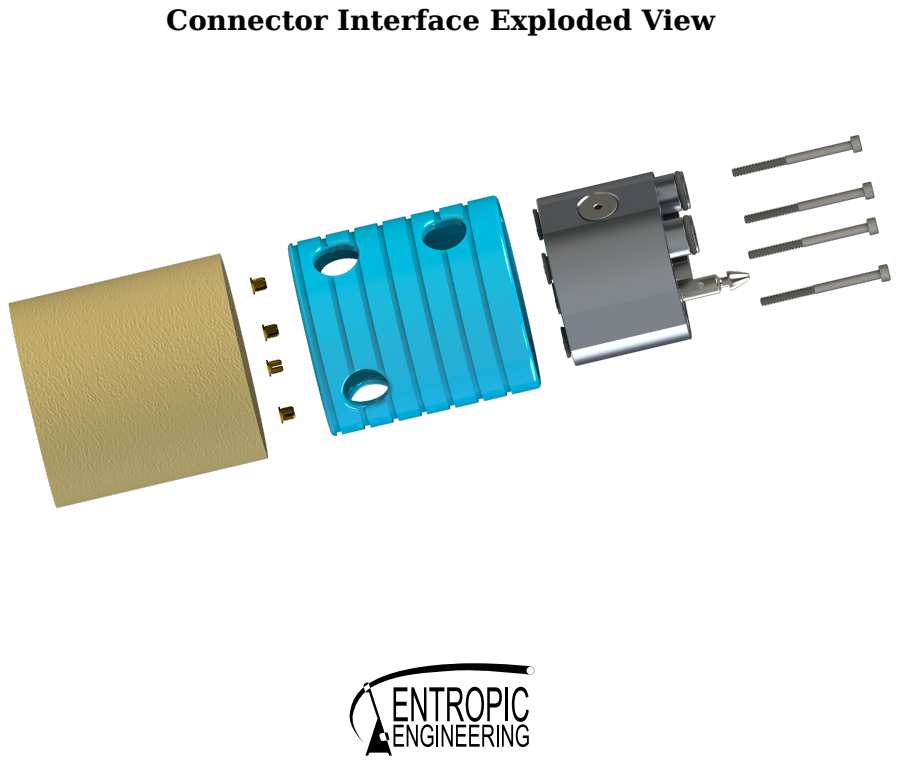
[picture p59: page 1]

Connector Interface Exploded View
