EntropicEngineering/amm_connector/documentation/latch_pin.pdf

## Latch Pin

## Turned from 17-4 Stainless Steel, hardened to

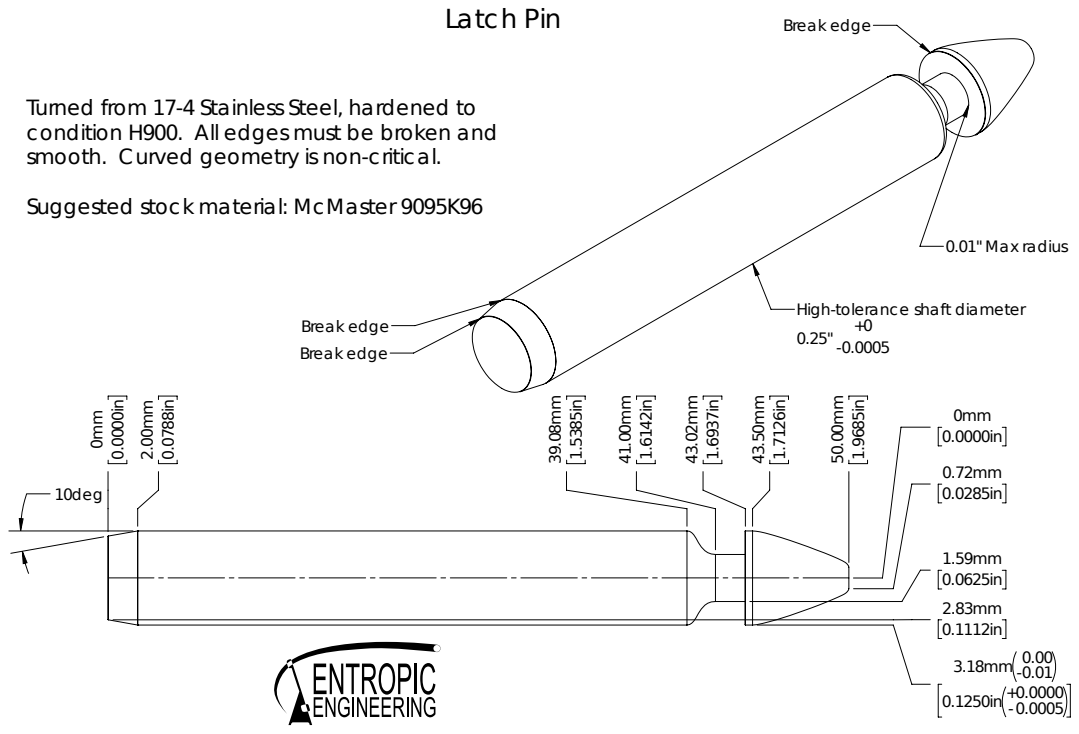
[picture p60: page 1]
10deg; 0.01" Max radius; Break edge; High-tolerance shaft diameter

condition H900. All edges must be broken and
smooth. Curved geometry is non-critical.

Suggested stock material: McMaster 9095K96
