EntropicEngineering/amm_connector/documentation/release_button.pdf

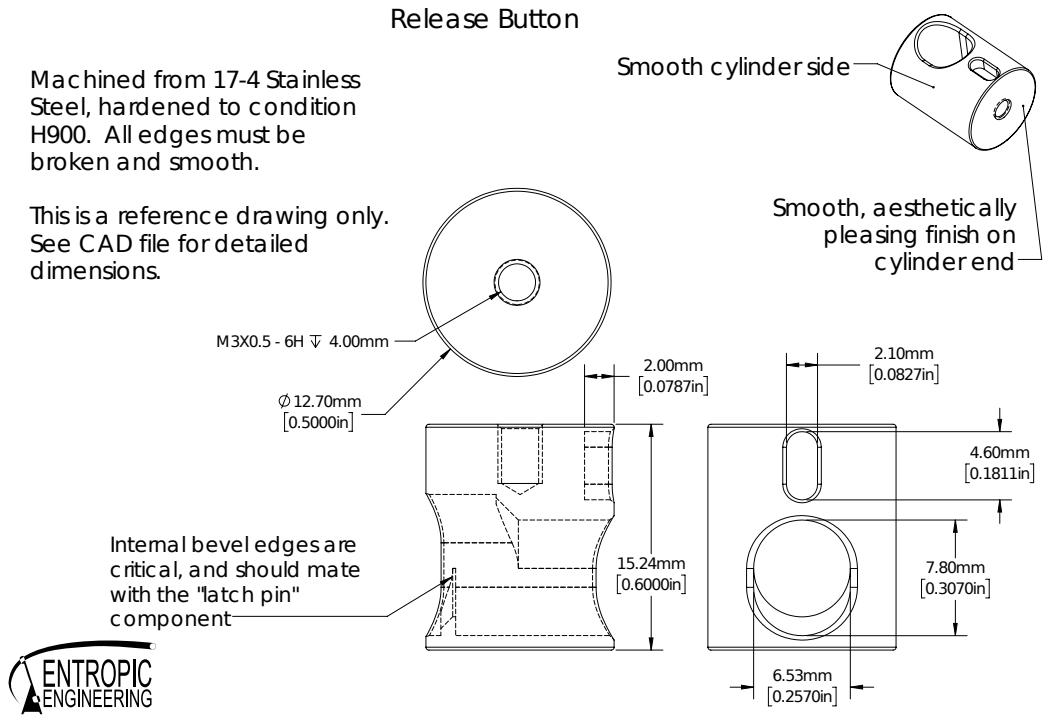
[picture p61: page 1]
Release Button

Smooth cylinder side

Machined from 17-4 Stainless
Steel, hardened to condition
H900. All edges must be
broken and smooth.

Smooth, aesthetically
pleasing finish on
cylinder end

This is a reference drawing only.
See CAD file for detailed
dimensions.

Internal bevel edges are
critical, and should mate
with the "latch pin"
component
