EntropicEngineering/amm_connector/(commit log)

2018-05-30 Made connector interface draft.
    [3100_56_00_99.sldasm, 3100_56_00_99_01.sldprt, 3100_56_00_99_02.sldprt, 3100_56_00_99_03.sldprt, 3100_56_00_99_04.sldprt, 3100_56_00_99_05.sldprt, connector.sldasm, connector.sldprt]
2018-05-31 Modifying ridges.
    [connector.sldasm, connector_interface.sldprt]
2018-06-02 Gathering files and drafting new housing.
    [173977-4.stp, 179472-8.stp, 292182-8.stp, 292185-8.stp, connector.sldasm, connector_a.sldprt, electrical_connector_a.sldprt, electrical_connector_b.sldprt]
2018-06-04 Designing new latch mechanism.
    [173977-4.stp, 179472-8.stp, 292182-8.stp, 292185-8.stp, 3100_56_00_99.sldasm, 3100_56_00_99_01.sldprt, 3100_56_00_99_02.sldprt, 3100_56_00_99_03.sldprt]
2018-06-05 Made latch pins.
    [connector.sldasm, connector_a.sldprt, latch_pin.sldprt, release_pin.sldprt]
2018-06-05 Made alternative latch mechanism.
    [connector.sldasm, connector_a.sldprt, electrical_assembly_a.sldasm, latch_pin_2.sldprt, release_pin_2.sldprt]
2018-06-06 Added bevel to release pin.
    [connector.sldasm, release_pin_2.sldprt]
2018-06-08 Added o-ring protrusions.
    [292178-1.sldprt, 292178-1.stp, 3-173977-1.sldprt, 3-173977-1.stp, connector.sldasm, connector_a.sldprt, latch_pin.sldprt, latch_pin_2.sldprt]
2018-06-09 Added new electrical connector, and o-ring protrusions.
    [011_o-ring.sldprt, 292178-1.sldprt, 3-173977-1.sldprt, 3100_56_00_99.sldasm, connector.sldasm, connector_a.sldprt, electrical_subassembly.sldasm, hose_connector_subassembly.sldasm]
2018-06-11 Finalizing O-ring grooves.
    [011_o-ring.sldprt, connector.sldasm, connector_a.sldprt]
2018-06-11 Plaed all tubing connectors in the assembly.
    [connector.sldasm]
2018-06-12 Improved release mechanism, and added mounting holes.
    [bom.ods, connector.sldasm, connector_a.sldprt, release_pin_2.sldprt]
2018-06-13 Redoing silicone interface, and latch mechanism.
    [bom.ods, connector.sldasm, connector_a.sldprt, m3_nut.sldprt, m3x40mm_screw.sldprt, release_pin_2.sldprt, silicone_interface.sldprt]
2018-06-15 Fixing schrader valves.
    [bom.ods, connector.sldasm, connector_a.sldprt, connector_housing.sldprt, electrical_pinout.ods, m3_threaded_insert.sldprt, m3x40mm_screw.sldprt, m3x6mm_screw.sldprt]
2018-06-16 Fixing latch mechanism.
    [bom.ods, connector_housing.sldprt, m3x3mm_screw.sldprt, m3x40mm_screw.sldprt, m3x6mm_screw.sldprt, release_pin_2.sldprt, silicone_interface.sldprt]
2018-06-16 Redid O-ring section.
    [011_o-ring.sldprt, 012_o-ring.sldprt, bom.ods, connector.sldasm, connector.sldprt, connector_housing.sldprt, connector_interface.sldprt, silicone_interface.sldprt]
2018-06-17 Added release button hole to silicone interface, and organized files.
    [173977-4.stp, 179472-8.stp, 292182-8.stp, 292185-8.stp, connector.sldasm, electrical_assembly_a.sldasm, electrical_connector_a.sldprt, electrical_connector_b.sldprt]
2018-06-18 Updated BOM.
    [bom.ods]
2018-07-03 Fixed various geometry.
    [connector_housing.sldprt]
2018-07-04 Fixing assembly geometry.
    [connector.sldasm, silicone_interface.sldprt, silicone_sleeve.sldprt]
2018-07-04 Changed latch mechanism.
    [connector.sldasm, connector_housing.sldprt, m3x8mm_set_screw.sldprt, release_pin_2.sldprt, silicone_interface.sldprt, silicone_sleeve.sldprt]
2018-07-07 Designing jigs.
    [bom.ods, conical_spring.sldprt, hose_press_jig.sldprt, release_pin_jig.sldasm, release_pin_jig.sldprt]
2018-07-10 Refining release pin.
    [connector.sldasm, connector_housing.sldprt, connector_housing_milspec.sldprt, latch_pin.sldprt, latch_pin_2.sldprt, release_pin.sldprt, release_pin_2.sldprt, silicone_interface.sldprt]
2018-07-16 Updated hardware.
    [010_o-ring.sldprt, 012_o-ring.sldprt, bom.ods, connector.sldasm, connector_housing_milspec.sldprt, electrical_pinout.ods, m3_nut.sldprt, m3_rubber_washer.sldprt]
2018-07-18 Optimizing latch geometry.
    [connector.sldasm, connector_housing.sldprt, latch_pin.sldprt, silicone_interface.sldprt]
2018-07-18 Changing O-ring gland to dynamic seal dimensions.
    [connector.sldasm, connector_housing.sldprt, silicone_interface.sldprt]
2018-07-22 Simplifying latch mechanism.
    [connector_housing.sldprt, latch_pin.sldprt, release_pin.sldprt]
2018-07-23 Starting drawing.
    [connector_housing.slddrw]
2018-07-24 Made drawing of connector housing.
    [connector_housing.slddrw, electrical_pinout.ods]
2018-07-24 Made soft jaws for the connector housing.
    [connector_housing.sldprt, connector_housing_soft_jaws.sldprt, silicone_interface.sldprt]
2018-07-28 Added guide pin to soft jaws, and pulled back silicone interface from connector front.
    [bom.ods, connector_housing_soft_jaws.sldprt, silicone_interface.sldprt]
2018-07-30 Fixing schrader valve timing.
    [connector_housing.sldprt, connector_housing_soft_jaws.sldprt, m8_schrader_valve.sldprt, silicone_interface.sldprt]
2018-08-02 Fiddling with O-ring geometry.
    [bom.ods, connector_housing.sldprt]
2018-08-02 Still fiddling with O-ring grooves.
    [connector_housing.sldprt]
2018-08-07 Increasing catch ledge.
    [connector.sldasm, connector_housing.sldprt, connector_housing_soft_jaws.sldprt, release_pin.sldprt, silicone_interface.sldprt]
2018-08-08 Making latch pin jig, and adjusting release pin geometry.
    [bom.ods, connector.sldasm, hose_press_jig.sldprt, latch_pin_press_jig.sldprt, release_pin.sldprt]
2018-08-10 Added set screw to soft jaws, and made jig block for second operation.
    [connector.sldasm, connector_housing_soft_jaws.sldprt, connector_pocket_jig.sldprt, m3x8mm_set_screw.sldprt]
2018-08-13 Made latch mechanism more secure.
    [connector.sldasm, connector_housing.sldprt, connector_housing_soft_jaws.sldprt, latch_pin.sldprt, silicone_interface.sldprt]
2018-08-14 Making latch pin drawings.
    [latch_pin.dxf, latch_pin.slddrw, latch_pin.sldprt]
2018-08-15 Made STEP file of the release pin.
    [release_pin.step]
2018-08-15 Renamed "release pin" to "realease button".
    [bom.ods, connector.sldasm, release_button.sldprt, release_button.step, release_button_jig.sldasm, release_button_jig.sldprt, release_pin.sldprt, release_pin_jig.sldasm]
2018-08-24 Made M10 schrader valve.
    [bom.ods, connector_housing_m10_test.sldprt, electrical_pinout.ods, m10_schrader_valve.sldprt]
2018-08-26 Starting on M10 schrader valve connector.
    [connector_housing_m10.sldprt, connector_housing_m10_test.sldprt]
2018-08-29 Making schrader test block.
    [bom.ods, connector_housing.sldprt, connector_housing_m10.sldprt, schrader_test_block.sldprt]
2018-08-29 Working on schrader valve test block.
    [electrical_pinout.ods, schrader_test_block.sldprt, schrader_valve_test_block.sldprt]
2018-09-11 Updated BOM and datasheets.
    [bom.ods, m10_schrader_valve.sldprt, m8_schrader_valve.sldprt, release_button.slddrw, release_button.sldprt]
2018-09-17 Made bend tester jig.
    [bend_test_jig.sldprt, connector.sldasm, connector_housing_soft_jaws.sldprt, m8_schrader_valve.sldprt, silicone_interface.sldprt]
2018-09-18 Altering bend test jig geometry for easy machining.
    [bend_test_jig.sldprt, connector.sldasm, electrical_pinout.ods, latch_pin.sldprt]
2018-09-21 Reduced bend test jig size.
    [bend_test_jig.sldprt]
2018-10-22 Increased taper on latch pin, added a threaded hole to the release button, and updated the BOM.
    [bom.ods, latch_pin.sldprt, release_button.sldprt]
2018-11-01 Designed latch pin spacer, and improved electrical reference diagram.
    [connector.sldasm, connector_housing.slddrw, connector_housing.sldprt, connector_housing_soft_jaws.sldprt, electrical_pinout.ods, latch_pin.sldprt, latch_pin_spacer.slddrw, latch_pin_spacer.sldprt]
2018-11-02 Finalizing connector design, and compiling documents.
    [005_o-ring.sldprt, 012_o-ring.sldprt, 1-173977-1.sldprt, 173977-4.stp, 179472-8.stp, 292182-8.stp, 292185-8.stp, bom.ods]
2018-12-05 Committing old things.
    [connector_housing.slddrw, connector_housing.sldprt, latch_pin.sldprt, release_button.sldprt]
2018-12-08 Added logo to housing.
    [connector_housing.sldprt, connector_housing.step]
2018-12-20 Added fusion 360 CAM backup file.
    [connector_cam.f3d]
2018-12-22 Added locking screws to the BOM.
    [bom.ods, connector_housing.sldprt]
2018-12-31 Fixed fluid bore dimensions, and redid documentation.
    [bom.ods, connector_cam.f3d, connector_housing.slddrw, connector_housing.sldprt, connector_housing_cam.f3d, electrical_pinout.ods]
2019-01-03 Update the pocket jig.
    [connector_pocket_jig.sldprt]
2019-08-21 Added backup CAM files.
    [connector_housing_cam.f3d, release_button_cam.f3d]
2019-10-28 Updated documentation.
    [connector_housing.slddrw]
2019-10-28 Fixed solidworks assembly constraint.
    [connector_housing_soft_jaws.sldprt, latch_pin_spacer.sldprt, silicone_interface.sldprt]
2019-12-22 Added bend test jig drawing.
    [bend_test_jig.slddrw, bend_test_jig.sldprt]
2022-07-11 Cleaning up repo.
    [292178-1.stp, 3-173977-1.stp, connector_housing.step, skin_f_3.obj]
2022-07-11 Increased latch pin shoulder depth to alleviate deformation.
    [connector_housing.sldprt, connector_housing_soft_jaws.sldprt, latch_pin_spacer.sldprt, silicone_interface.sldprt]
